LucaDorinAnton/6CCS3PRJ/Report/Appendices/SourceCode.tex

\chapter{Source Code}
This chapter contains the list of all source code created during this project.

\section{Originality Pledge}
``I verify that I am the sole author of the programs contained in this folder, except where explicitly stated to the contrary'' \\
Luca-Dorin Anton - 23 April 2020
\section{MicroCode generator}

\subsection{classes.py}
\lstinputlisting[language=Python]{../../microcode/classes.py}
\subsection{microcode.py}
\lstinputlisting[language=Python]{../../microcode/microcode.py}
\subsection{microinstructions.py}
\lstinputlisting[language=Python]{../../microcode/microinstructions.py}
\subsection{yamlparser.py}
\lstinputlisting[language=Python]{../../microcode/yamlparser.py}
\subsection{microinstructions.yaml}
\lstinputlisting{../../microcode/microinstructions.yaml}

\section{Assembler}
\subsection{assembler.scala}
\lstinputlisting[language=Scala]{../../build-tools/src/main/scala/assembler/assembler.scala}
\subsection{lexer.scala}
\lstinputlisting[language=Scala]{../../build-tools/src/main/scala/assembler/lexer.scala}
\subsection{LexerCore.scala}
\lstinputlisting[language=Scala]{../../build-tools/src/main/scala/assembler/LexerCore.scala}
\subsection{regexdef.scala}
\lstinputlisting[language=Scala]{../../build-tools/src/main/scala/assembler/regexdef.scala}
\subsection{regexdef.scala}
\lstinputlisting[language=Scala]{../../build-tools/src/main/scala/assembler/regexdef.scala}
\subsection{yamlparser.scala}
\lstinputlisting[language=Scala]{../../build-tools/src/main/scala/assembler/yaml_parser.scala}

\section{Compiler}
\subsection{ast.scala}
\lstinputlisting[language=Scala]{../../build-tools/src/main/scala/compiler/ast.scala}
\subsection{compiler.scala}
\lstinputlisting[language=Scala]{../../build-tools/src/main/scala/compiler/compiler.scala}
\subsection{lexer.scala}
\lstinputlisting[language=Scala]{../../build-tools/src/main/scala/compiler/lexer.scala}
\subsection{parser.scala}
\lstinputlisting[language=Scala]{../../build-tools/src/main/scala/compiler/parser.scala}

\section{Assembler and Compiler Script}
\subsection{script.scala}
\lstinputlisting[language=Scala]{../../build-tools/src/main/scala/script/script.scala}

\section{I/O Driver}
\subsection{io.ino}
\lstinputlisting[language=C++]{../../ardu-drivers/io/io.ino}
\subsection{io.py}
\lstinputlisting[language=Python]{../../ardu-drivers/io/io.py}

\section{Programming Driver}
\subsection{prog.ino}
\lstinputlisting[language=C++]{../../ardu-drivers/prog/prog.ino}
\subsection{prog.py}
\lstinputlisting[language=Python]{../../ardu-drivers/prog/prog.py}
