LucaDorinAnton/6CCS3PRJ/Report/Appendices/picture.tex

  \begin{figure}[h]
    \centering
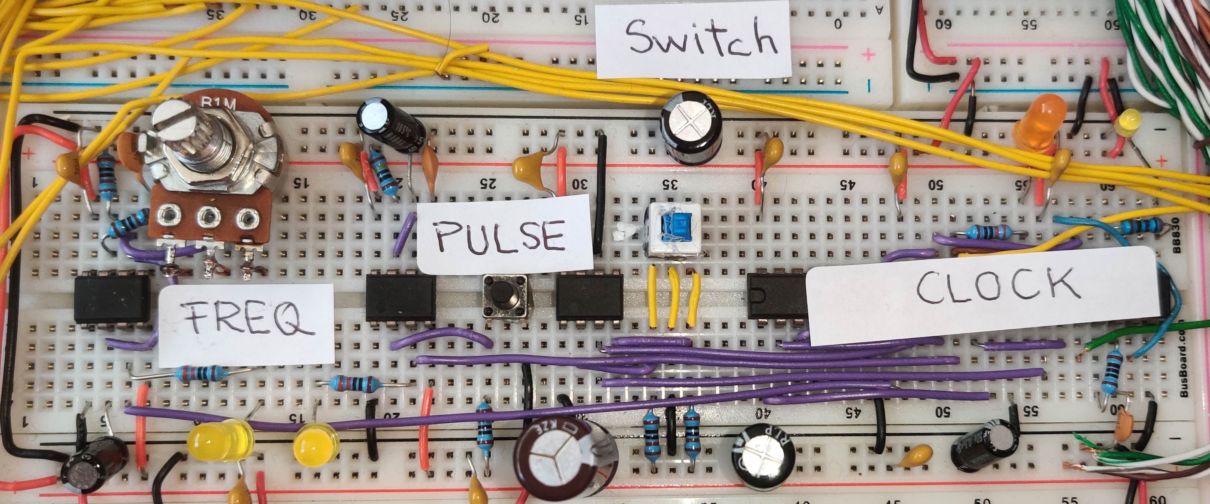
[picture p18: Report/Images/comp/clock.jpg]
    
    \caption{Clock implementation}
    \label{clock-i}
  \end{figure}

  \begin{figure}[h]
    \centering
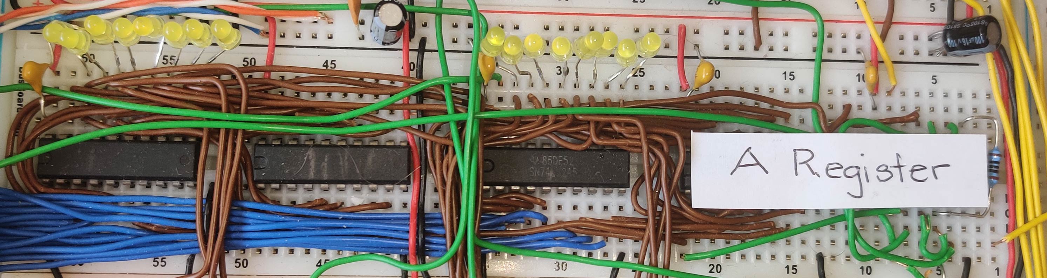
[picture p19: Report/Images/comp/a-reg.jpg]
    
    \caption{A register implementation}
    \label{a-reg-i}
  \end{figure}

  \begin{figure}[h]
    \centering
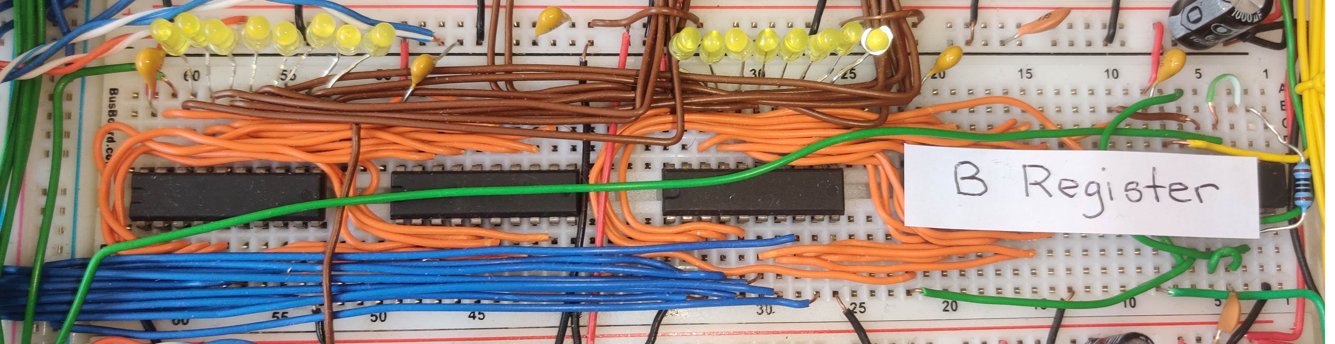
[picture p20: Report/Images/comp/b-reg.jpg]
    
    \caption{B register implementation}
    \label{b-reg-i}
  \end{figure}

  \begin{figure}[h]
    \centering
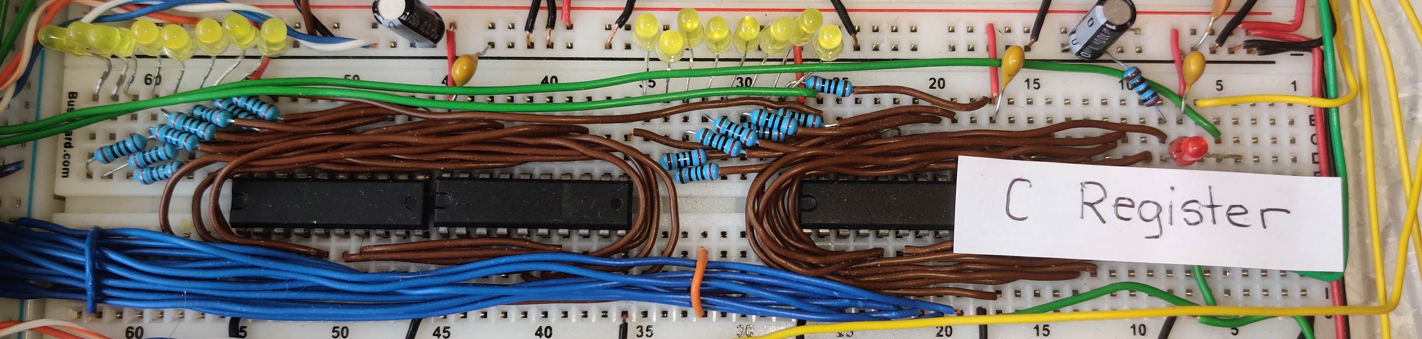
[picture p21: Report/Images/comp/c-reg.jpg]
    
    \caption{C register implementation}
    \label{c-reg-i}
  \end{figure}

  \begin{figure}[h]
    \centering
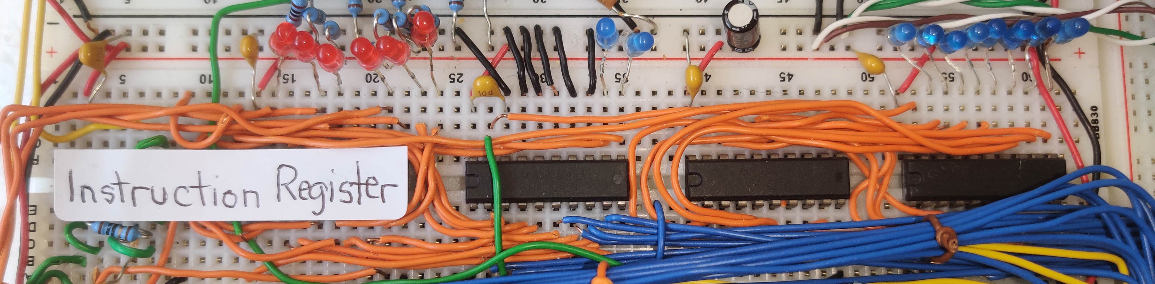
[picture p22: Report/Images/comp/ir.jpg]
    
    \caption{Instruction register implementation}
    \label{ir-i}
  \end{figure}

  \begin{figure}[h]
    \centering
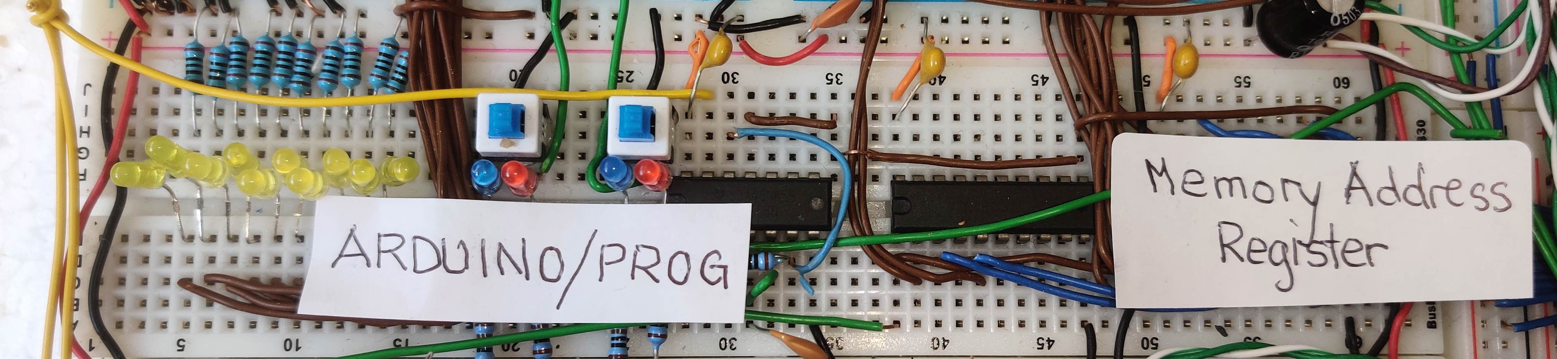
[picture p23: Report/Images/comp/mar.jpg]
    
    \caption{Memory address register implementation}
    \label{mar-i}
  \end{figure}

  \begin{figure}[h]
    \centering
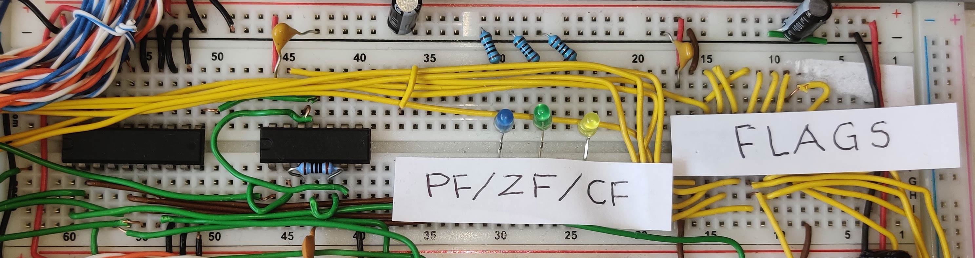
[picture p24: Report/Images/comp/flags.jpg]
    
    \caption{Flags register implementation}
    \label{flags-i}
  \end{figure}

  \begin{figure}[h]
    \centering
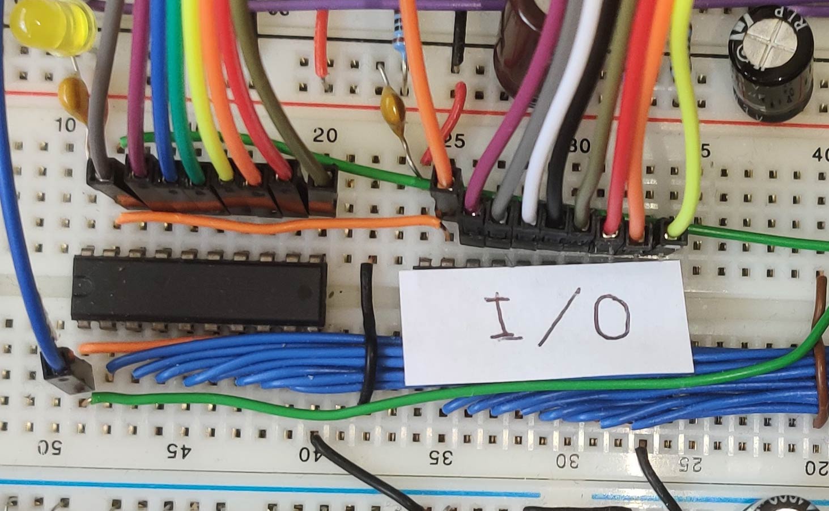
[picture p25: Report/Images/comp/io.jpg]
    
    \caption{Input/Output implementation}
    \label{io-i}
  \end{figure}

  \begin{figure}[h]
    \centering
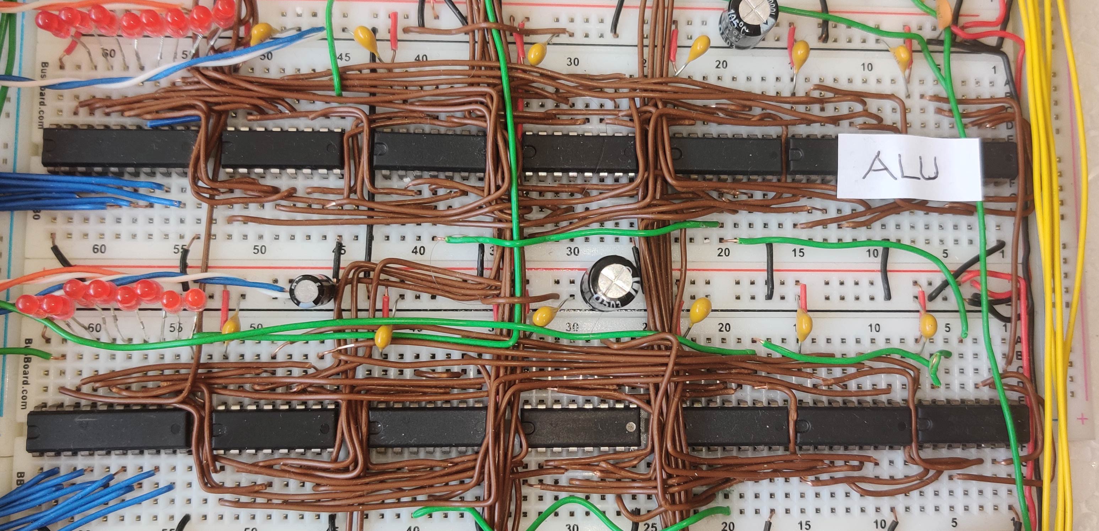
[picture p26: Report/Images/comp/alu.jpg]
    
    \caption{Arithmetic-Logic Unit implementation}
    \label{alu-i}
  \end{figure}

  \begin{figure}[h]
    \centering
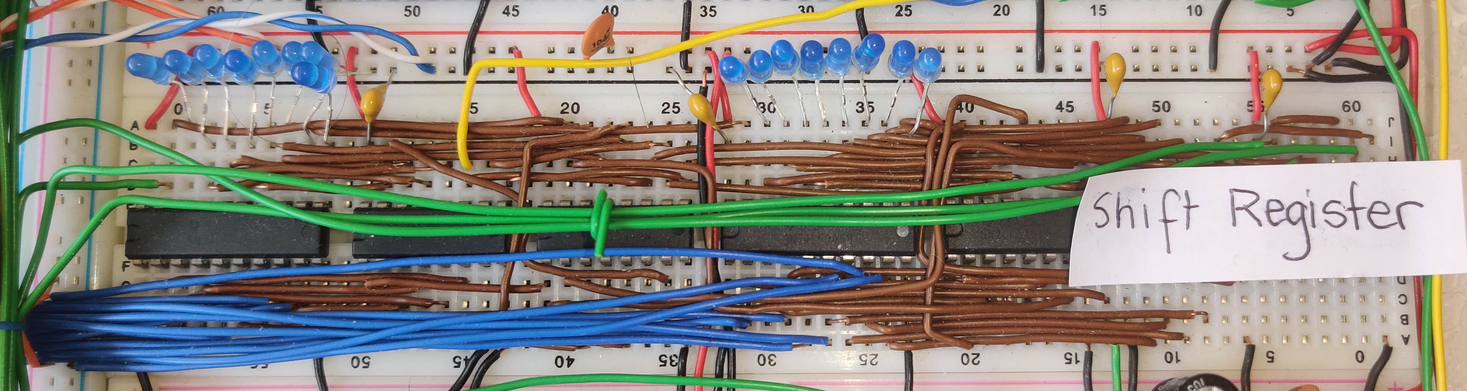
[picture p27: Report/Images/comp/shift-reg.jpg]
    
    \caption{Shift Register implementation}
    \label{shift-reg-i}
  \end{figure}

  \begin{figure}[h]
    \centering
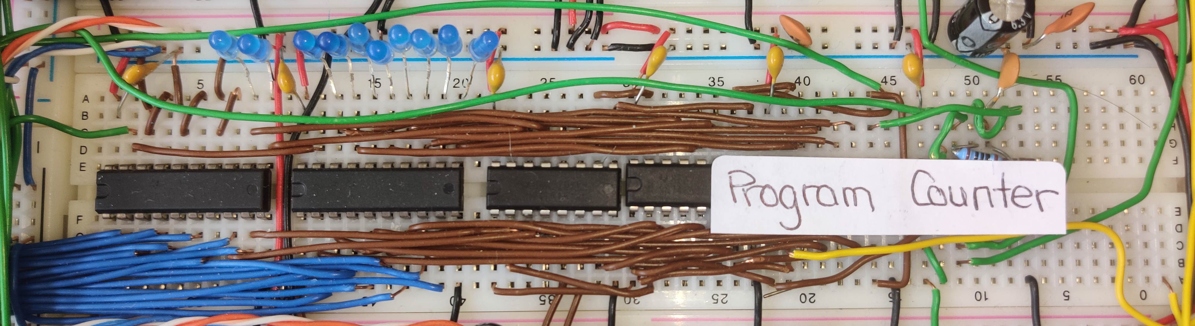
[picture p28: Report/Images/comp/pc.jpg]
    
    \caption{Program Counter implementation}
    \label{pc-i}
  \end{figure}

  \begin{figure}[h]
    \centering
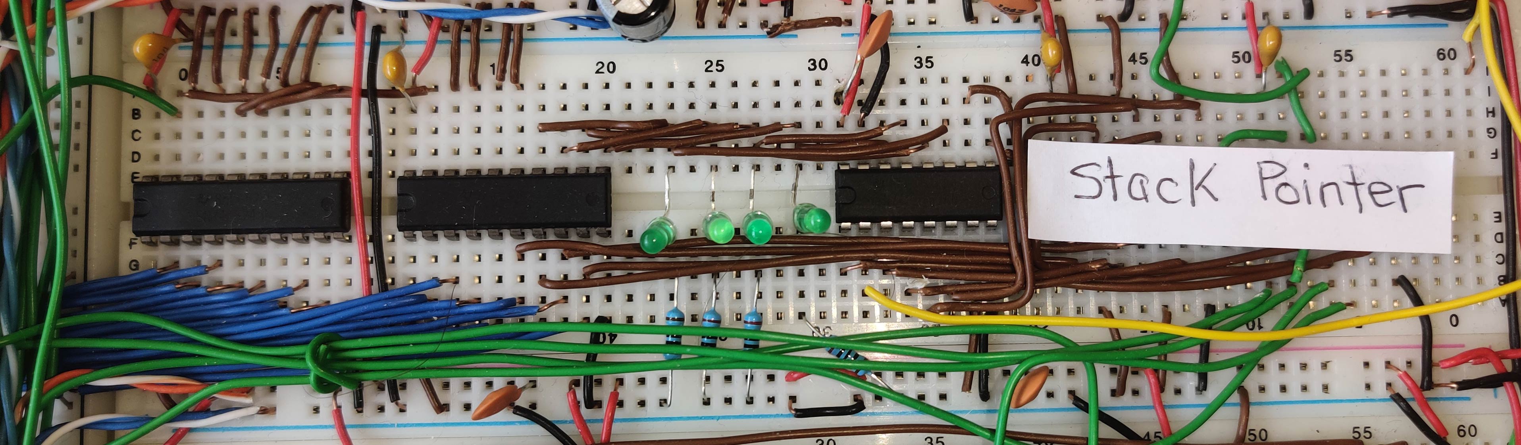
[picture p29: Report/Images/comp/sp.jpg]
    
    \caption{Stack Pointer implementation}
    \label{sp-i}
  \end{figure}

  \begin{figure}[h]
    \centering
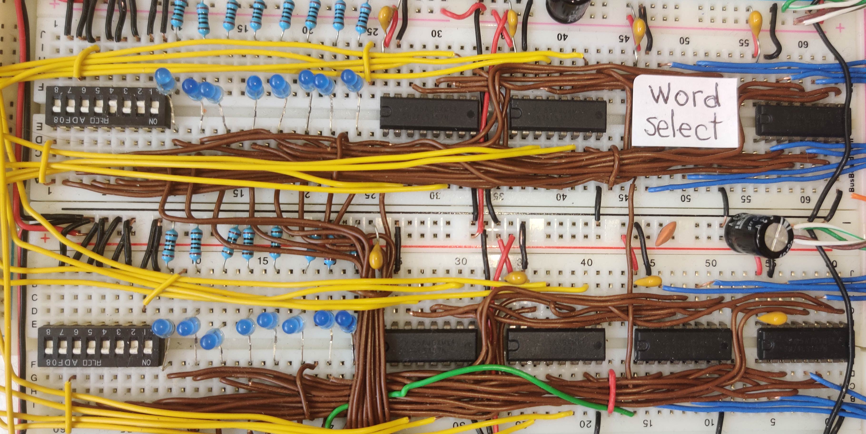
[picture p30: Report/Images/comp/word-select.jpg]
    
    \caption{Word selector implementation}
    \label{word-select-i}
  \end{figure}

  \begin{figure}[h]
    \centering
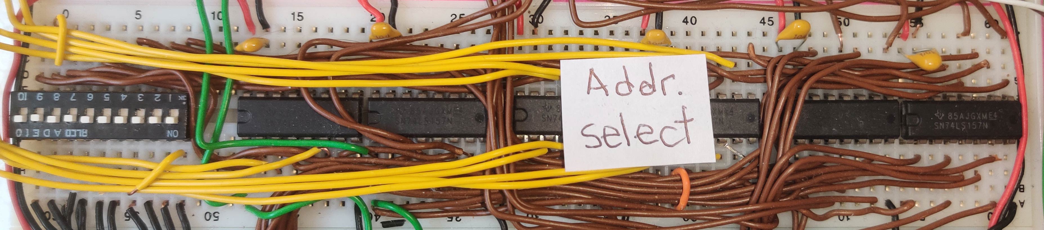
[picture p31: Report/Images/comp/addr-select.jpg]
    
    \caption{Address selector implementation}
    \label{addr-select-i}
  \end{figure}

  \begin{figure}[h]
    \centering
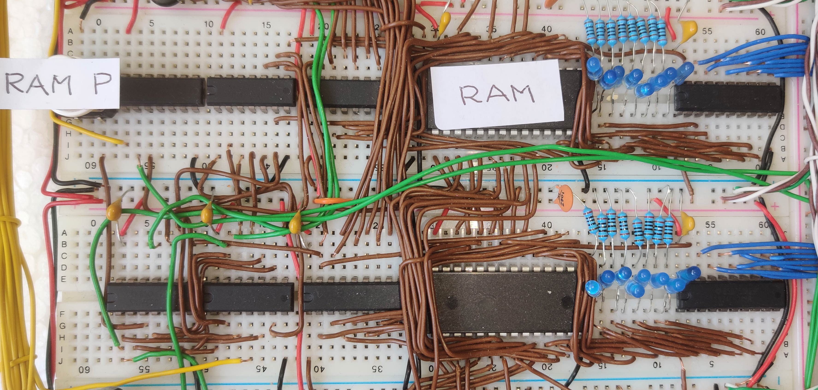
[picture p32: Report/Images/comp/ram.jpg]
    
    \caption{Random Access Memory implementation}
    \label{ram-i}
  \end{figure}

  \begin{figure}[h]
    \centering
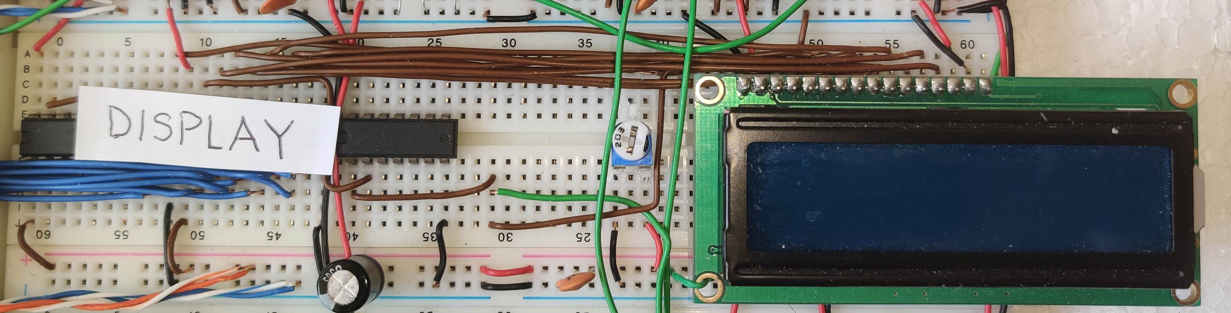
[picture p33: Report/Images/comp/display.jpg]
    
    \caption{Display implementation}
    \label{display-i}
  \end{figure}

  \begin{figure}[h]
    \centering
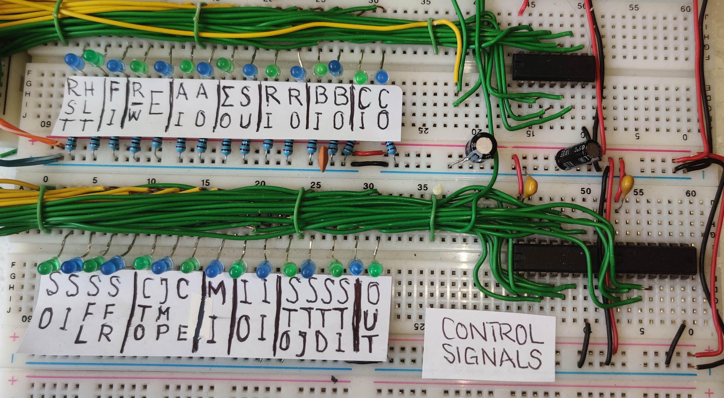
[picture p34: Report/Images/comp/control-sigs.jpg]
    
    \caption{Implementation of the contol signals module}
    \label{control-sigs-i}
  \end{figure}

  \begin{figure}[h]
    \centering
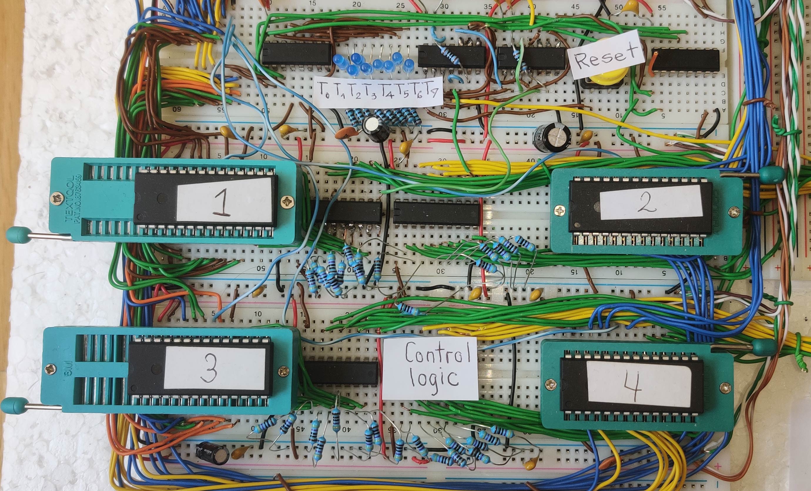
[picture p35: Report/Images/comp/control-logic.jpg]
    
    \caption{Control Logic implementation}
    \label{control-logic-i}
  \end{figure}

  \begin{figure}[h]
    \centering
    
    \caption{High level overview (with bus and LEDs visible)}
    \label{high-level-i}
  \end{figure}

\cleardoublepage
\cleardoublepage
