LucaDorinAnton/6CCS3PRJ/photoshop/BPS-BB830_Top.jpg

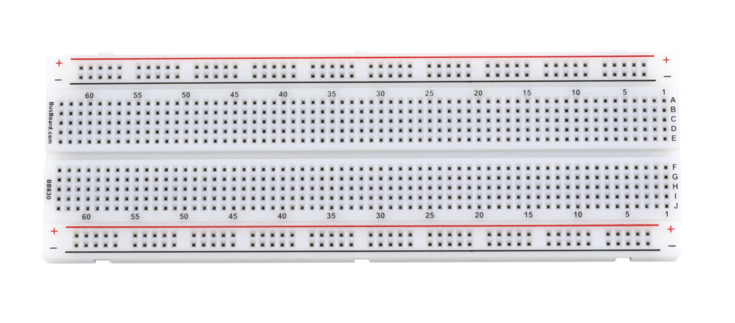
photoshop/BPS-BB830_Top.jpg
