LucaDorinAnton/6CCS3PRJ/Report/Images/close_up_low_level.jpg

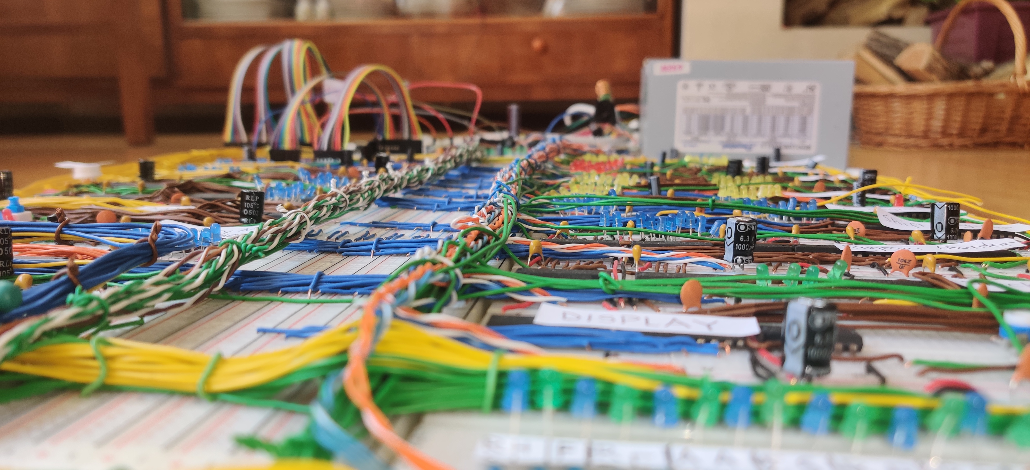
Report/Images/close_up_low_level.jpg
