LucaDorinAnton/6CCS3PRJ/Report/Images/comp/arduinos.jpg

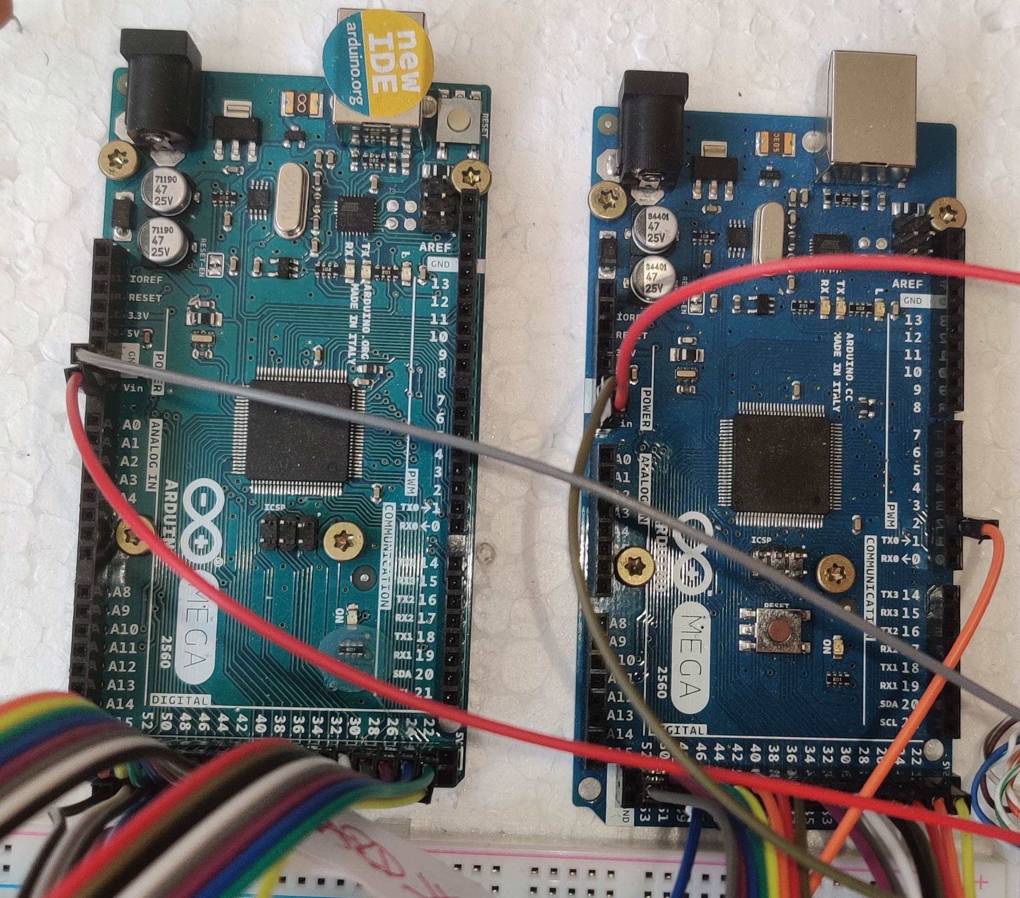
Report/Images/comp/arduinos.jpg
