LucaDorinAnton/6CCS3PRJ/Report/Images/comp/leds_and_ground.jpg

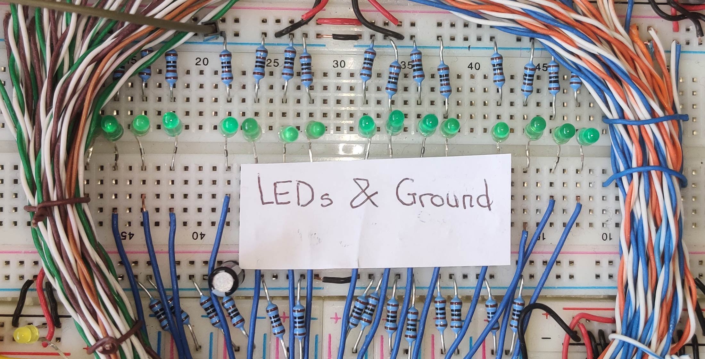
Report/Images/comp/leds_and_ground.jpg
