LucaDorinAnton/6CCS3PRJ/Report/Images/trans.PNG

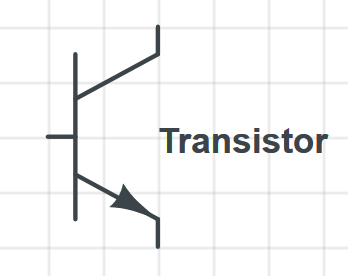
Report/Images/trans.PNG
