LucaDorinAnton/6CCS3PRJ/Other/Shopping List.xlsx

No | Code | Name | Needed | Cnty. | Unit Price | Total Price | Link
1 | MCBB830 | Breadboard | 15 | 17 | 3.67 | 62.39 | https://uk.farnell.com/multicomp/mcbb830/bread-board-abs-solderless-56/dp/2527467
2 | MCBB100 | Strips | 5 | 8 | 1.75 | 14 | https://uk.farnell.com/multicomp/mcbb100/bread-board-abs-165-3mm-x-20-5mm/dp/2764642?MER=sy-me-pd-mi-alte
3 | MCFYU6104Z6 (https://uk.farnell.com/multicomp/mcfyu6104z6/cap-0-1-f-50v-y5v/dp/9411887) | Caps 0.1 uF | 15 | 20 | 0.191 | 3.82 | https://uk.farnell.com/c/passive-components/capacitors/ceramic-capacitors/ceramic-disc-plate-capacitors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
4 | Se furaaaaa | R 220 Ohm | 150 | 200 |  | 0
5 | 1-1825002-3 (https://uk.farnell.com/te-connectivity/1-1825002-3/dip-switch-8pos-spst-slide/dp/2452332) | Dip Switches 8x | 2 | 2 | 0.8 | 1.6 | https://uk.farnell.com/te-connectivity/1-1825002-3/dip-switch-8pos-spst-slide/dp/2452332
6 | 1825057-9 (https://uk.farnell.com/te-connectivity/1825057-9/dip-switch-10pos-spst-slide/dp/2468732) | Dip Switches 10x | 1 | 1 | 1.15 | 1.15 | https://uk.farnell.com/te-connectivity/1825057-9/dip-switch-10pos-spst-slide/dp/2468732
7 | 74ls04 | hex inverter | 5 | 10 |  | 0 | https://uk.farnell.com/texas-instruments/sn74ls04n/ic-hex-inverter-74lso4-14dip/dp/3120520?st=74ls04
8 | 74ls08 | 4x 2 input and gates | 14 | 20 | 0.428 | 8.56 | https://uk.farnell.com/texas-instruments/sn74ls04n/ic-hex-inverter-74lso4-14dip/dp/1106072?st=74ls04
9 | 74ls32 | 4x 2 input or gates | 4 | 10 | 0.415 | 4.15 | https://uk.farnell.com/texas-instruments/cd74hc32e/logic-2-in-or-gate-quad-hs-14dip/dp/3120203
10 | 74ls273 | 8 bit register | 11 | 15 | 0.518 | 7.77 | https://uk.farnell.com/texas-instruments/sn74ls273n/ic-flipflop-8-circuits-17ns-20dip/dp/1470820?st=74ls273
11 | 74ls245 | tri state buffers | 24 | 30 | 0.543 | 16.29 | https://uk.farnell.com/texas-instruments/sn74ls245n/ic-74ls-74ls245-dip20-5-25v/dp/1106085?st=74ls245
12 | 74ls86 | 4x 2 input xor | 4 | 8 | 0.358 | 2.864 | https://uk.farnell.com/texas-instruments/sn74ls86an/logic-quad-2-in-ex-or-gate-14dip/dp/1740036?st=74ls86
13 | 74ls283 | 4 bit adder | 4 | 8 | 1.2 | 9.6 | https://uk.farnell.com/texas-instruments/sn74ls283n/logic-4bit-binary-full-adder-16dip/dp/3121044?st=74ls283
14 | 74ls02 | 4x 2 input nor | 3 | 6 | 0.458 | 2.748 | https://uk.farnell.com/texas-instruments/sn74ls02n/logic-quad-2-input-nor-gate-14dip/dp/3120517?st=74ls02
15 | 74ls194 | 4 bit shift register | 4 | 6 | 1.16 | 6.96 | https://uk.farnell.com/texas-instruments/sn74ls194an/logic-bi-dir-univ-shift-reg-16dip/dp/3120870?st=74ls194
16 | 74ls157 | 2 to 1 multiplexer | 15 | 20 | 0.57 | 11.4 | https://uk.farnell.com/texas-instruments/sn74ls157n/ic-74ls-74ls157-dip16-5-25v/dp/3121113?st=74ls157
17 | 74ls161 | 4 bit counter | 4 | 6 | 0.529 | 3.174 | https://uk.farnell.com/texas-instruments/sn74ls161an/ic-counter-multiplier-divider/dp/1470779?st=74ls161
18 | 74ls00 | 4x 2 input nand | 3 | 6 | 0.387 | 2.322 | https://uk.farnell.com/texas-instruments/sn74ls00n/logic-quad-2-in-nand-gate-14dip/dp/1740021?st=74ls00
19 | MC21605C6W | Display | 1 | 1 | 7.35 | 7.35 | https://uk.farnell.com/midas/mc21605c6w-spr-v2/display-alphanumeric-16x2-nobacklight/dp/2675590?st=MC21605C6W
20 | 74ls169 | up/down counter | 1 | 2 | 1.05 | 2.1 | https://uk.farnell.com/texas-instruments/sn74ls169bn/logic-sync-4bit-up-dn-cntr-16dip/dp/1739788?ost=74ls169
21 | 74ls138 | 3 to 8 line decoder | 1 | 2 | 0.494 | 0.988 | https://uk.farnell.com/texas-instruments/sn74ls138n/logic-3-8-line-decoder-demux-16dip/dp/1739824?st=74ls138
22 | 28C64 | EEPROM | 4 | 6 | 3.8 | 22.8 | https://uk.farnell.com/atmel/at28c64b-15pu/parallel-eeprom-64kbit-dip-28/dp/2748830
23 | LY62256PL-55LLI | RAM | 2 | 3 | 4.53 | 13.59 | https://uk.farnell.com/lyontek/ly62256pl-55lli/sram-256k-32kx8-2-7-5-5v-28pdip/dp/2253656?ost=LY62256PL-55LLI
24 | tl866II | Eeprom programmer | 1 | 1 | 38.49 | 38.49 | https://www.amazon.co.uk/WINGONEER%C2%AE-TL866II-Performance-EEPROM-Programmer/dp/B07B985LBS
25 |  |  |  |  |  | 0
26 |  |  |  |  |  | 0
27 |  |  |  |  |  | 0
28 |  |  |  |  |  | 0
29
 |  |  |  |  | TOTAL: | 244.116
