LucaDorinAnton/6CCS3PRJ/microcode/instruction_list.txt

NOP
LDA
LAI
LDB
LBI
LDC
LCI
LDS
LSI
ADD
SUB
SFL
SFR
JMP
JPI
BRZ
BRP
BRC
MAB
MAC
MAS
MBA
MBC
MBS
MCA
MCB
MCS
MSA
MSB
MSC
STA
STB
STC
STS
JSR
RET
IRA
IRB
IRC
IRS
IRR
IWA
IWB
IWC
IWS
IWR
DWA
DWB
DWC
DWS
DWR
LAP
LBP
LCP
LSP
RST
HLT
