LucaDorinAnton/6CCS3PRJ/KiCad/breadboard_comp_schematic.pdf

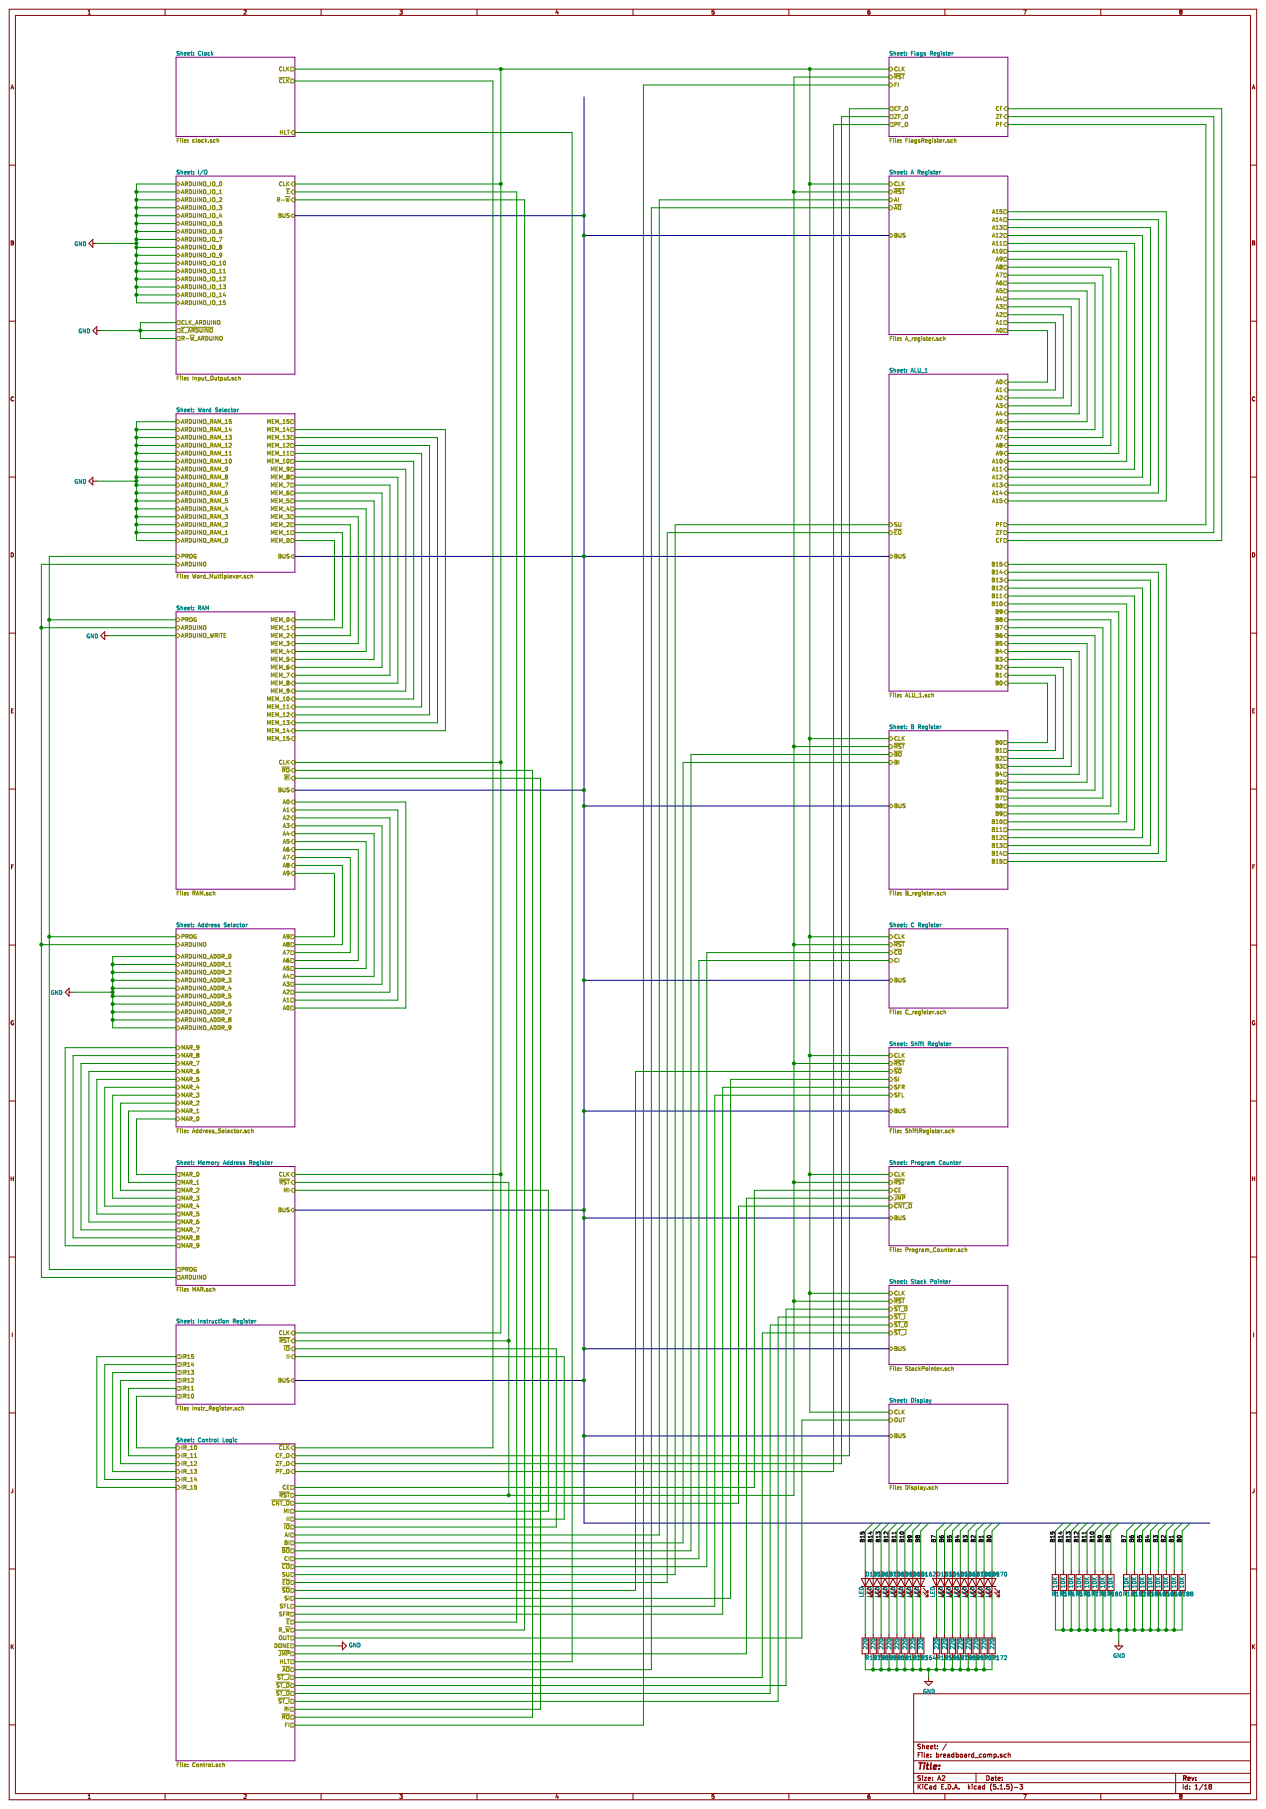
[picture p73: page 1]

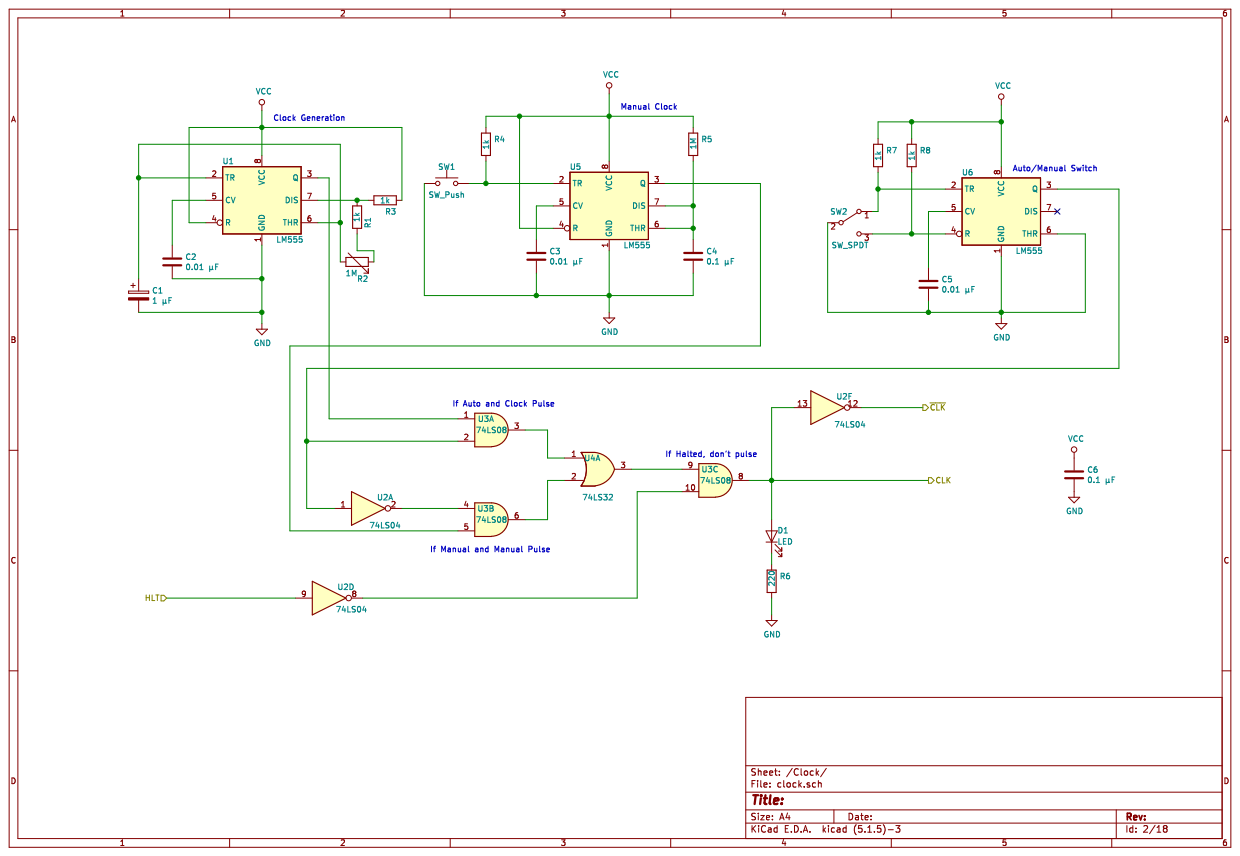
[picture p74: page 2]

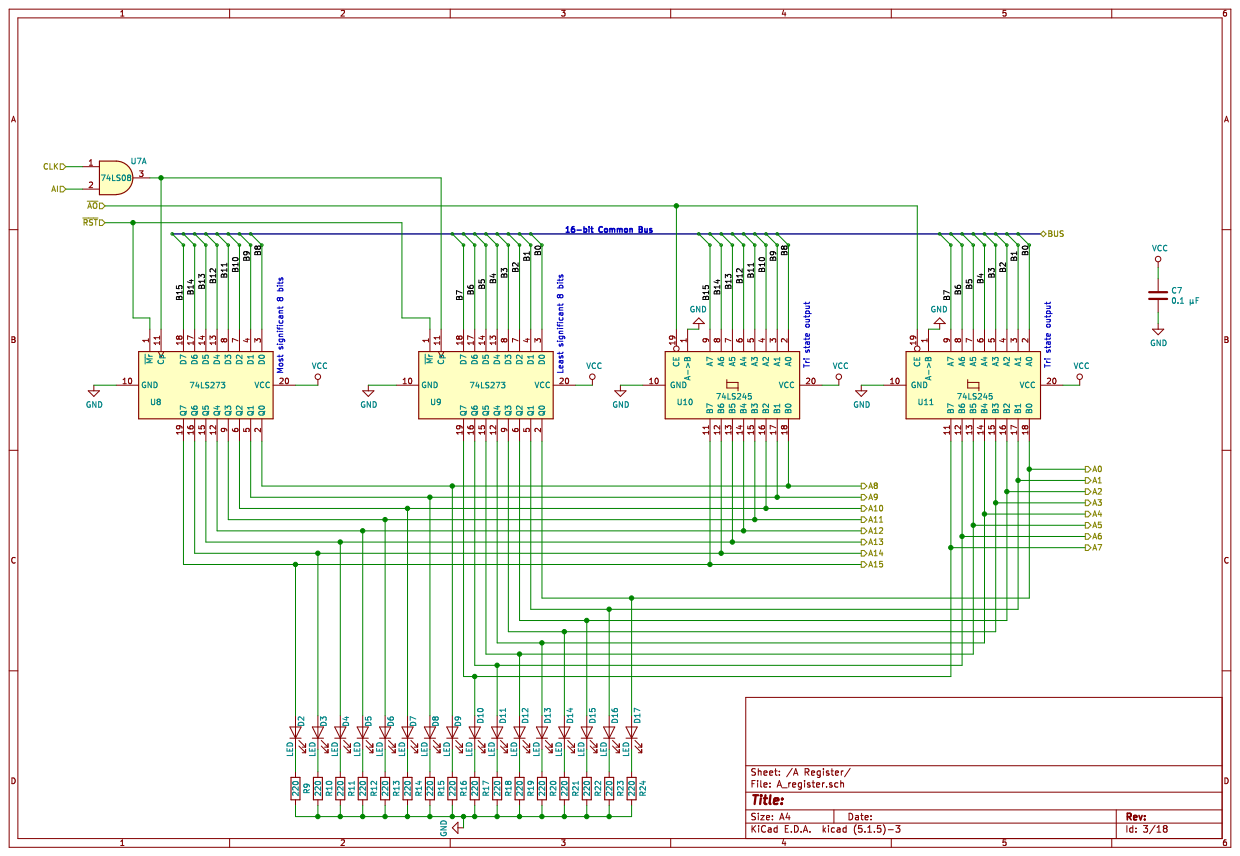
[picture p75: page 3]

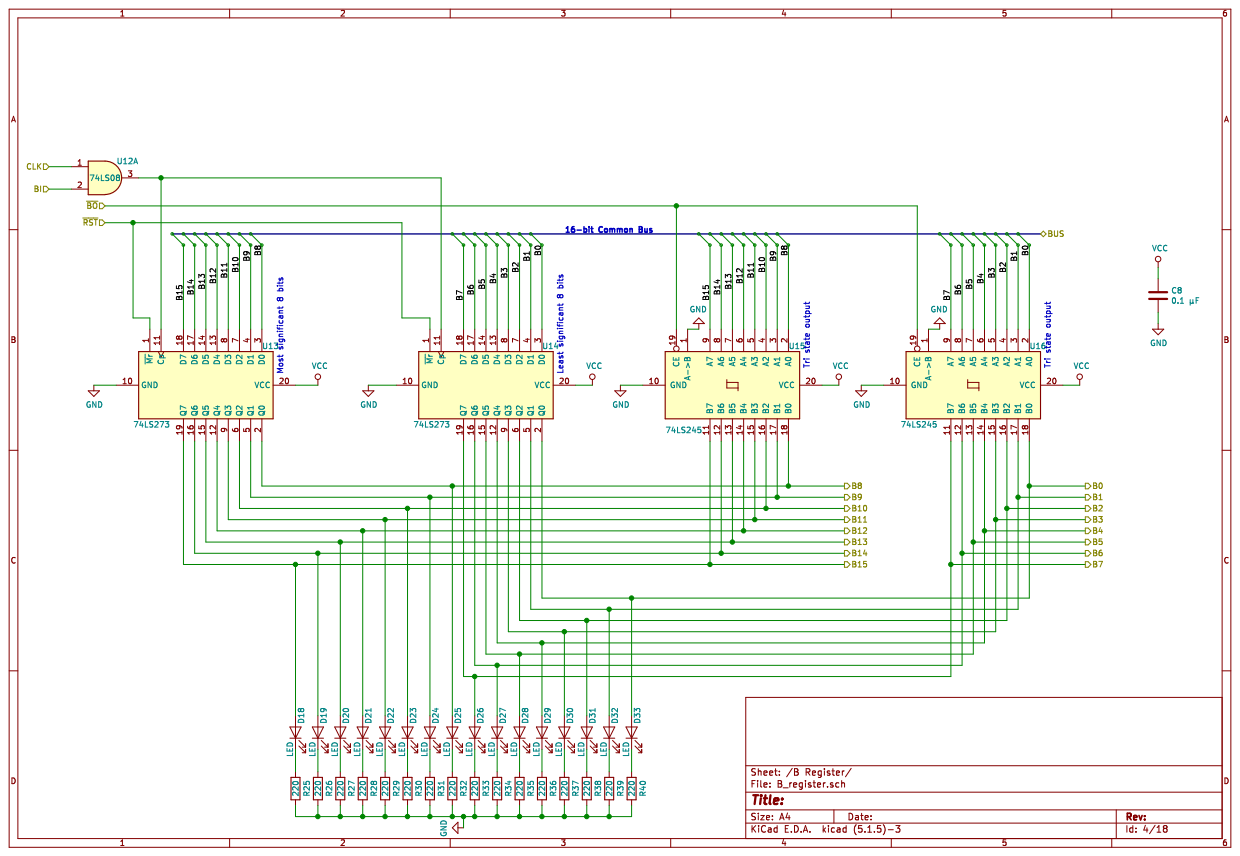
[picture p76: page 4]

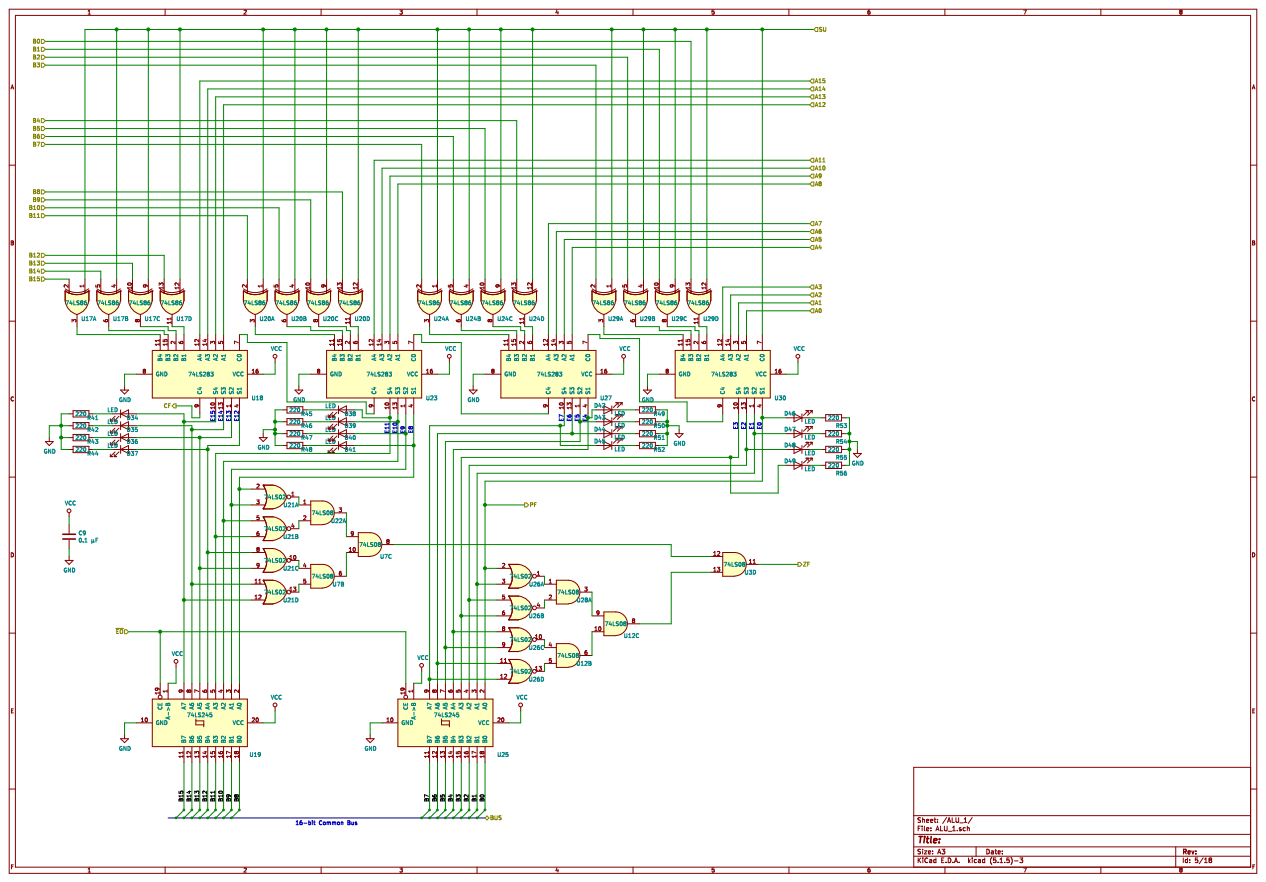
[picture p77: page 5]

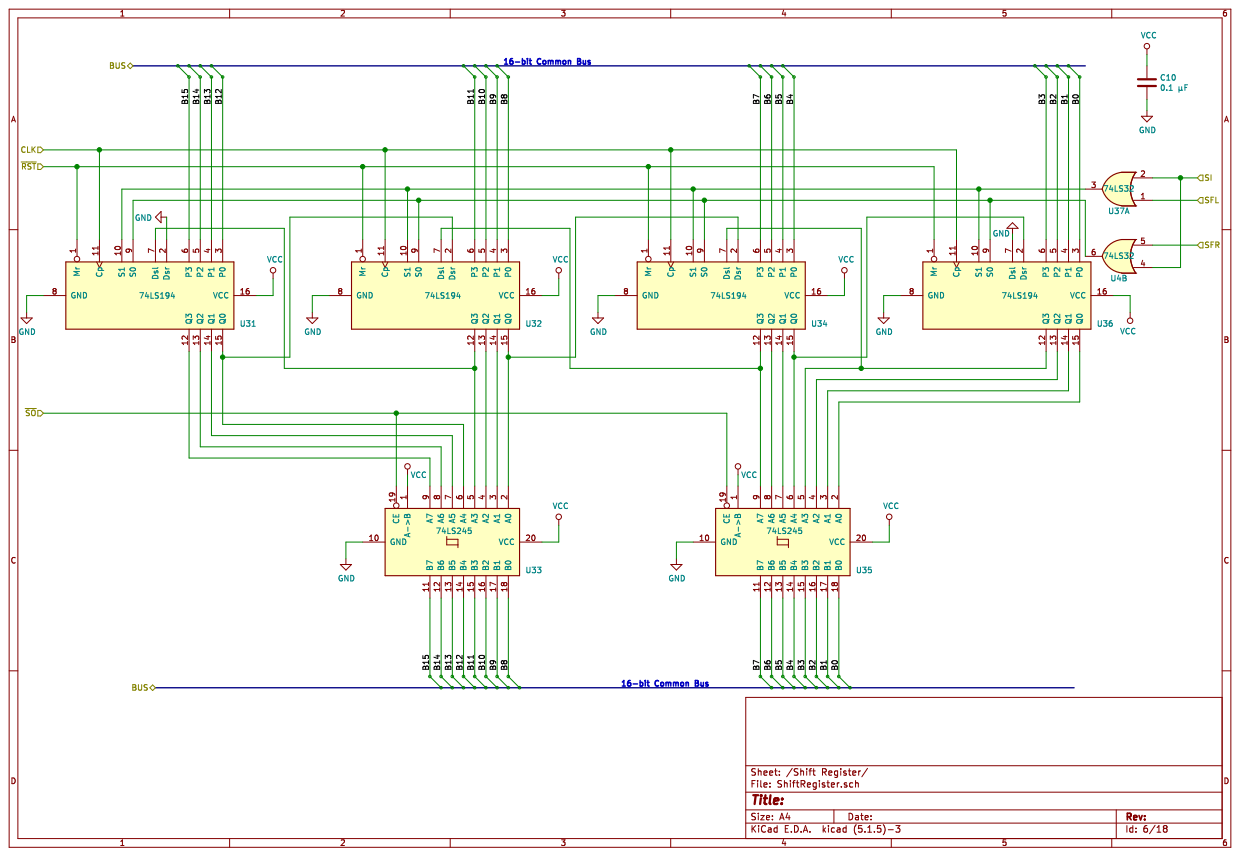
[picture p78: page 6]

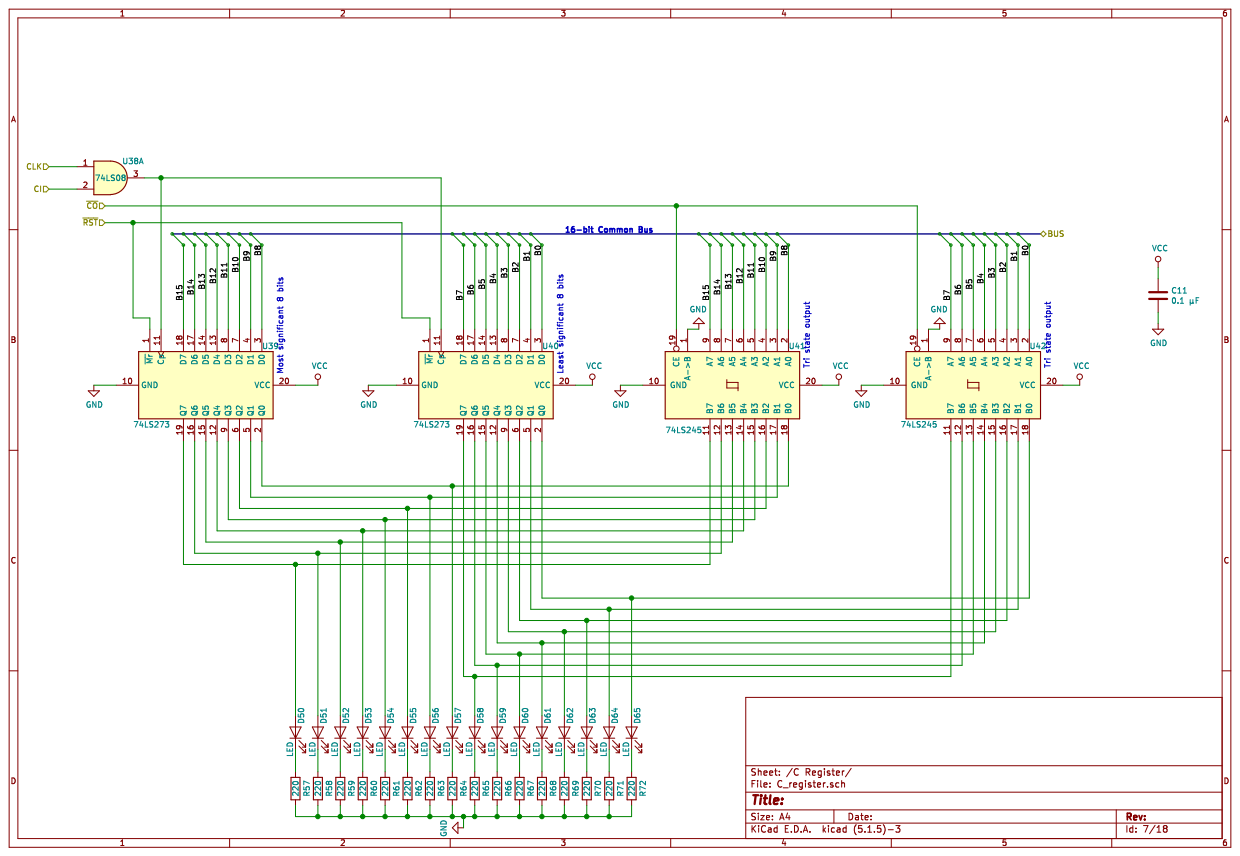
[picture p79: page 7]

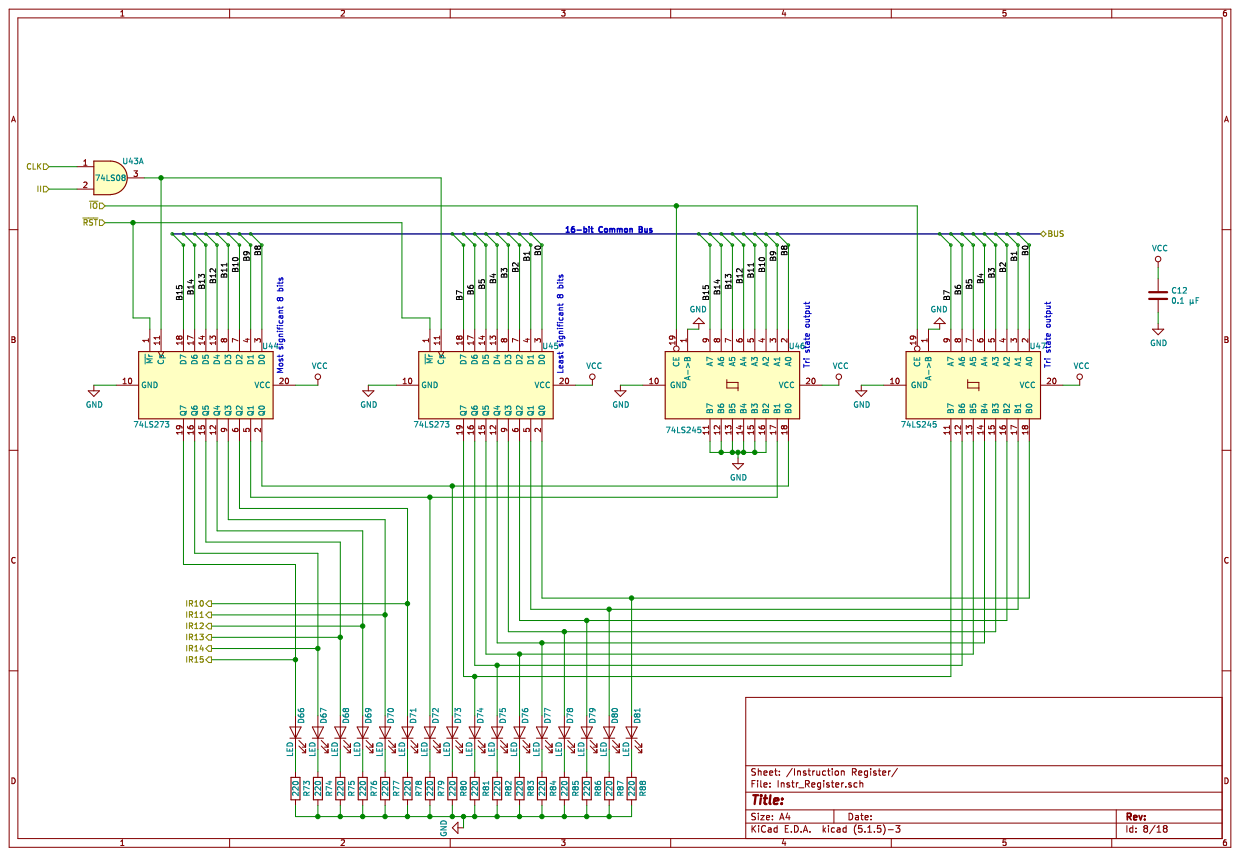
[picture p80: page 8]

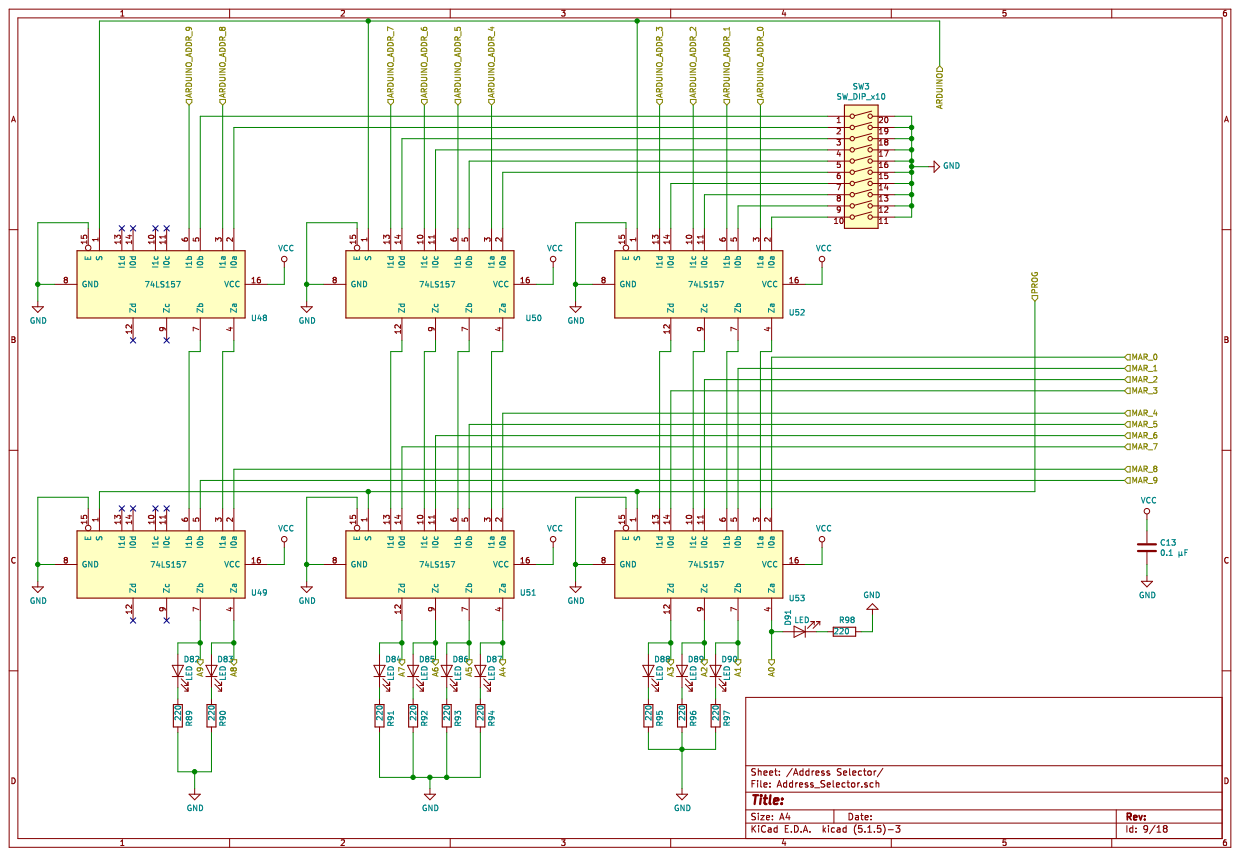
[picture p81: page 9]

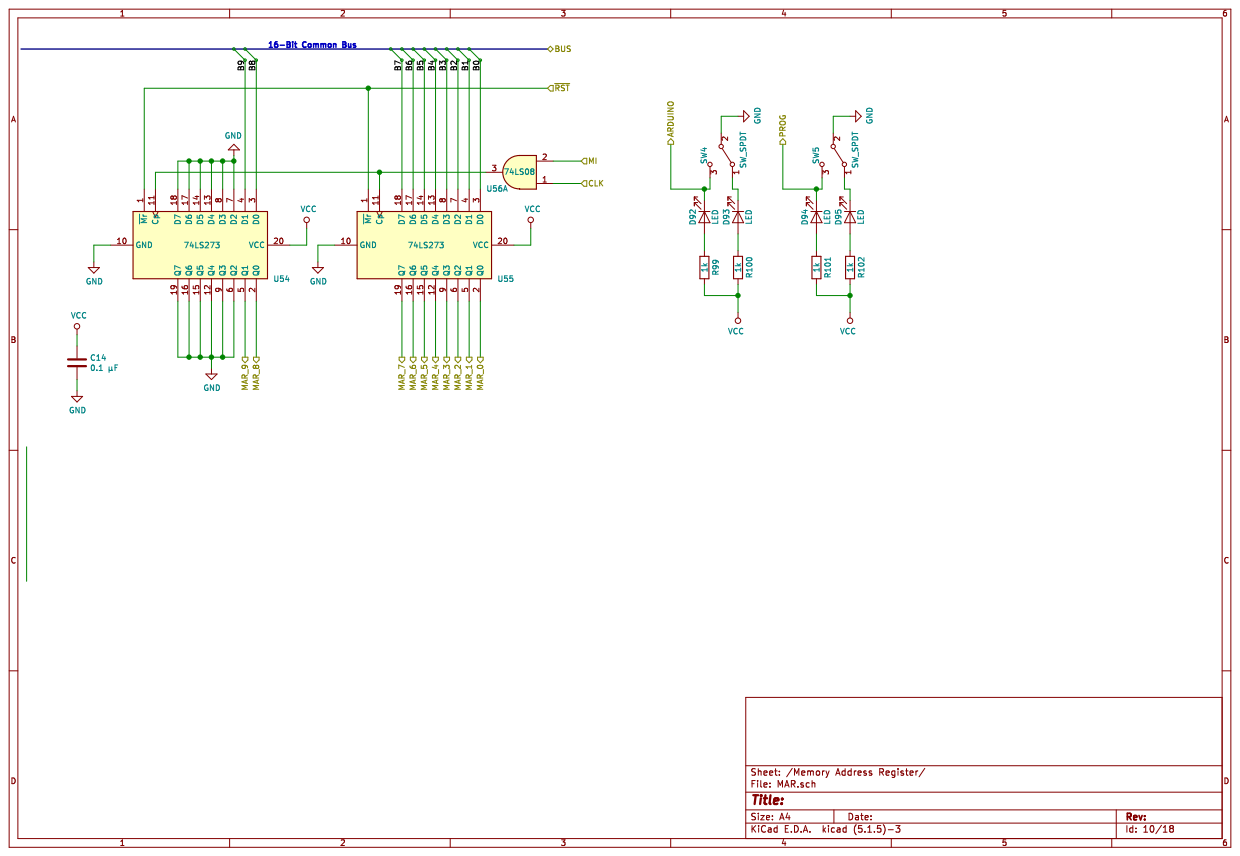
[picture p82: page 10]

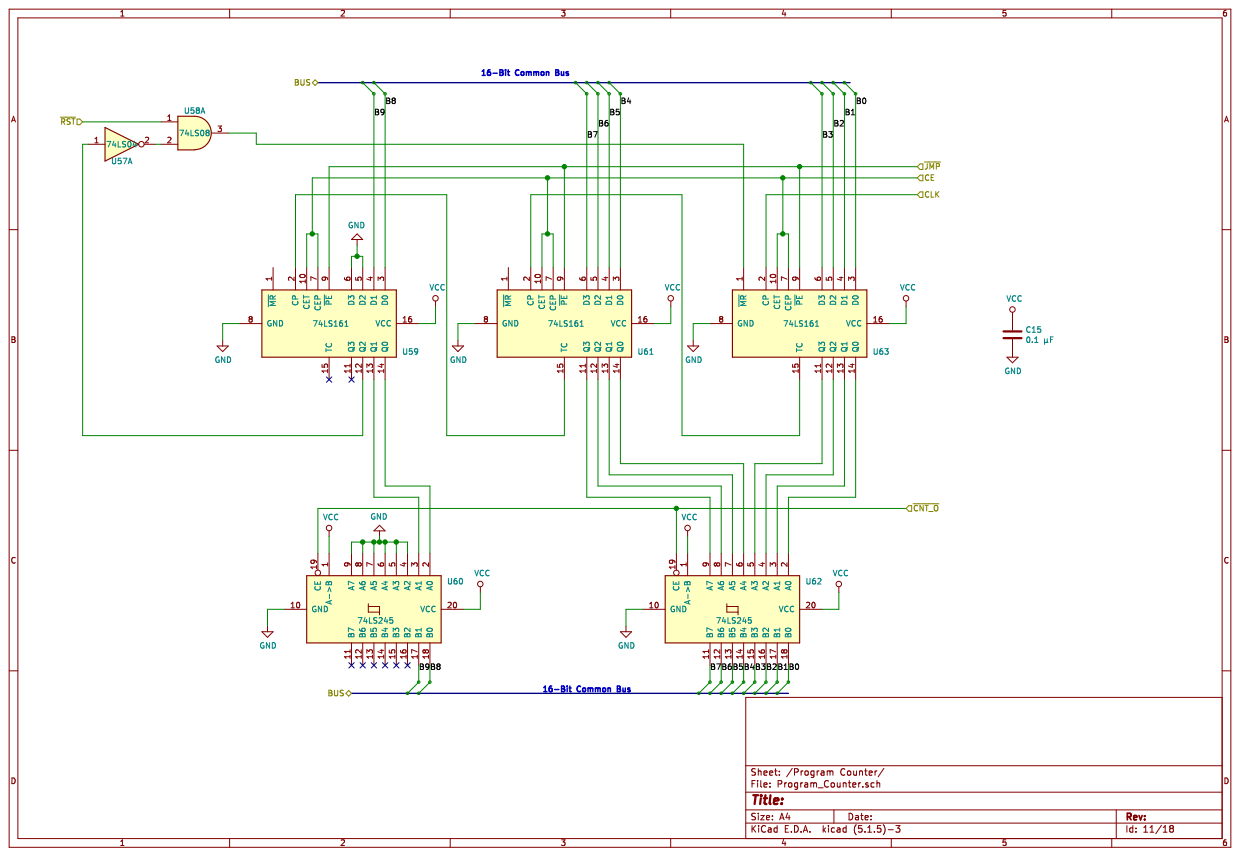
[picture p83: page 11]

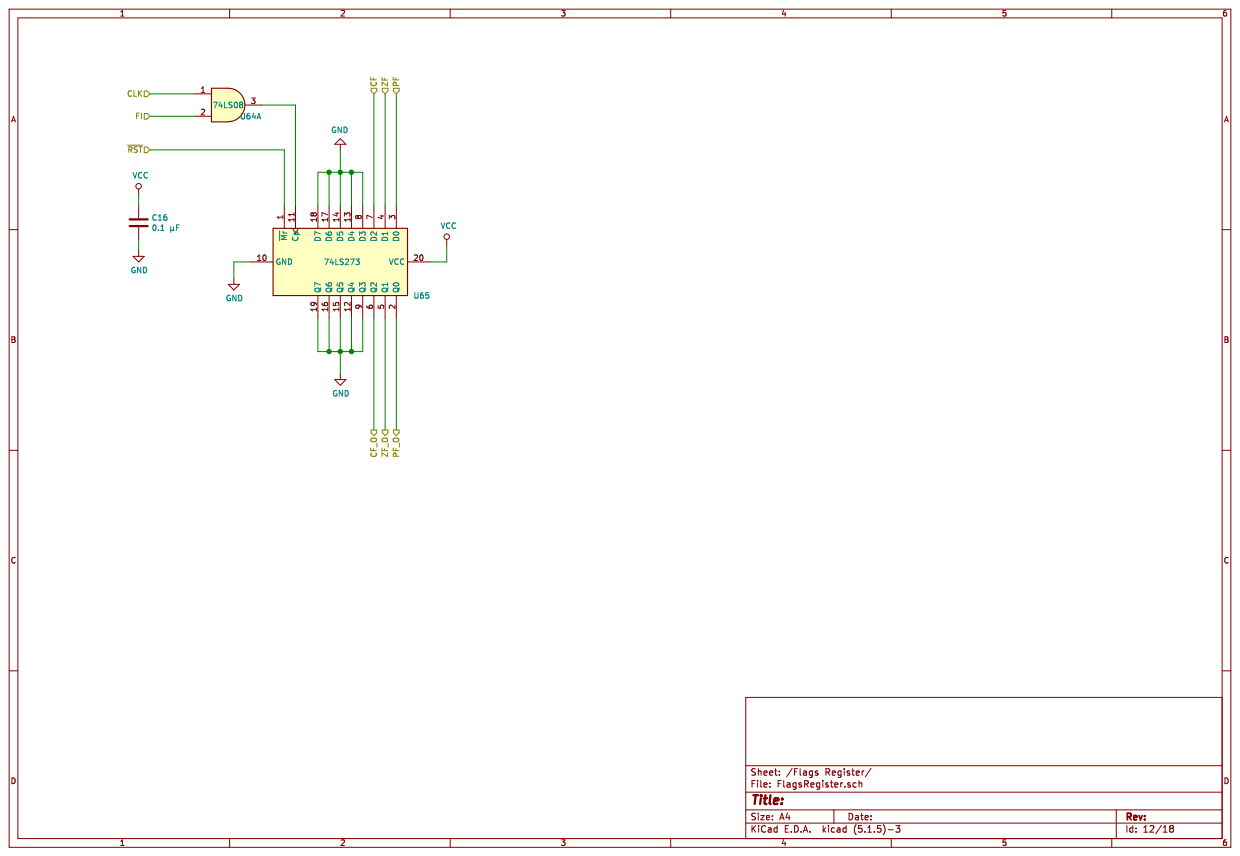
[picture p84: page 12]

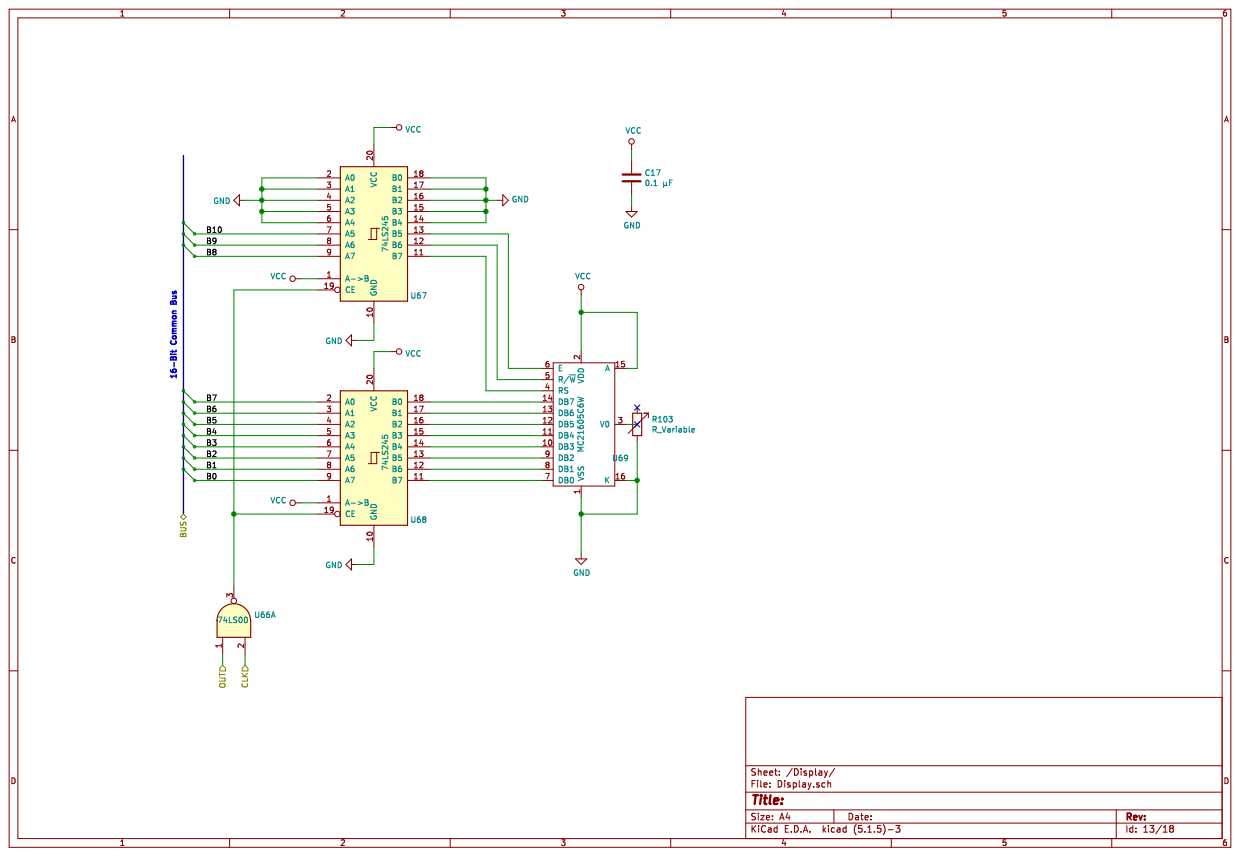
[picture p85: page 13]

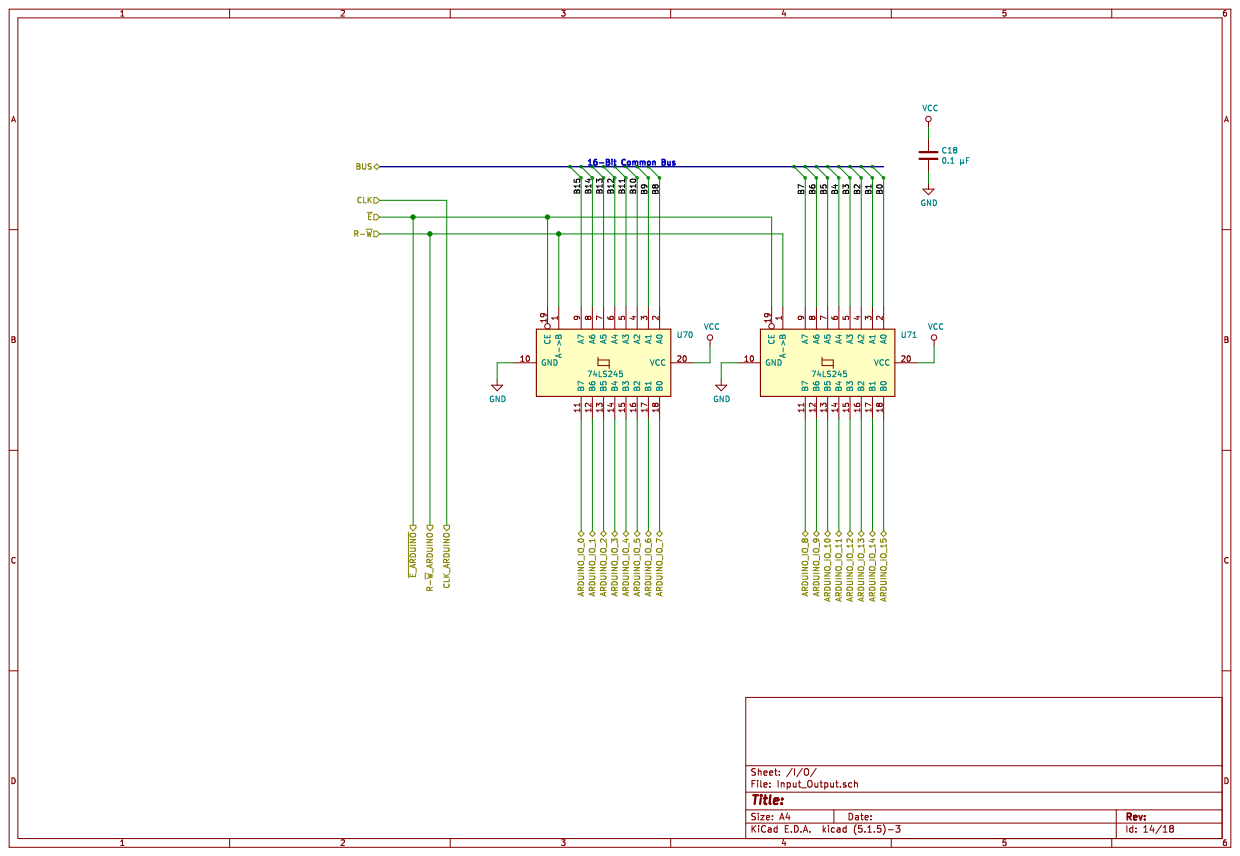
[picture p86: page 14]

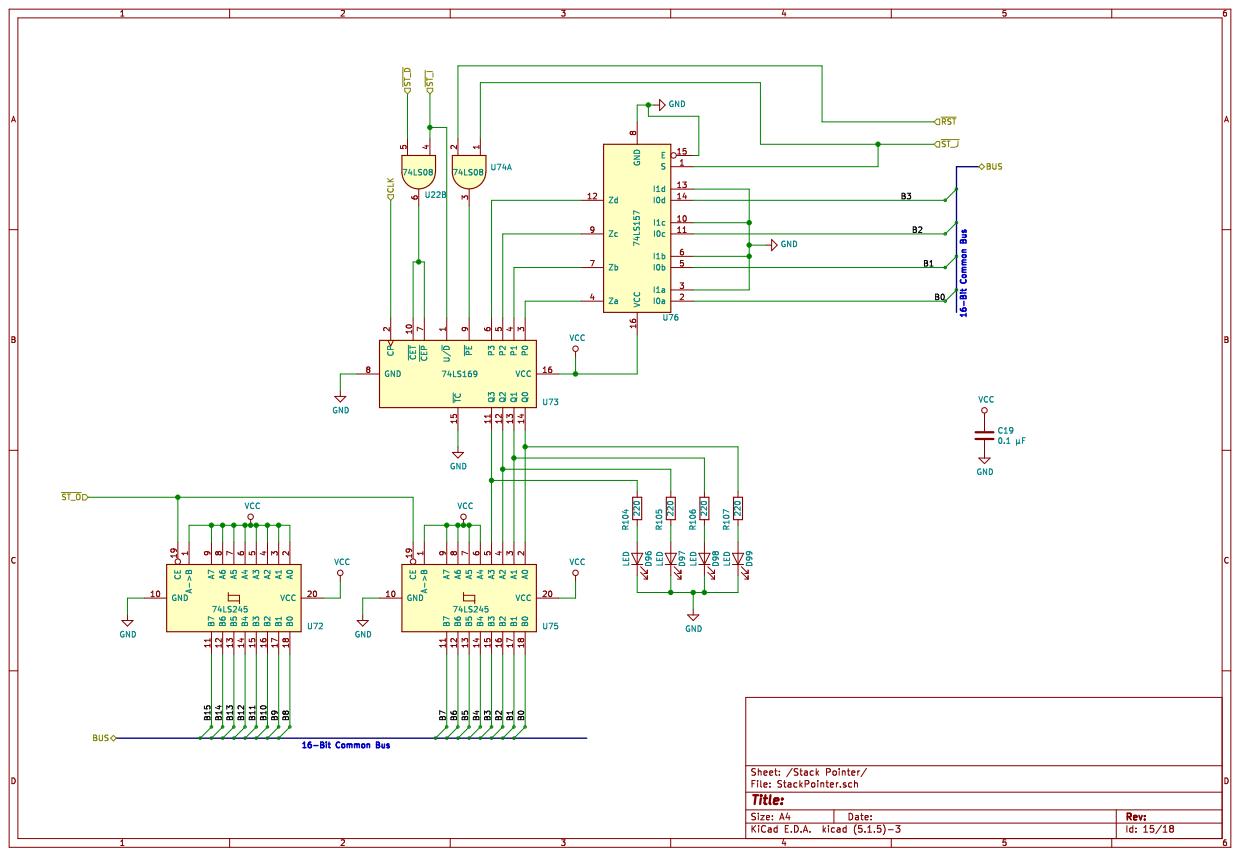
[picture p87: page 15]

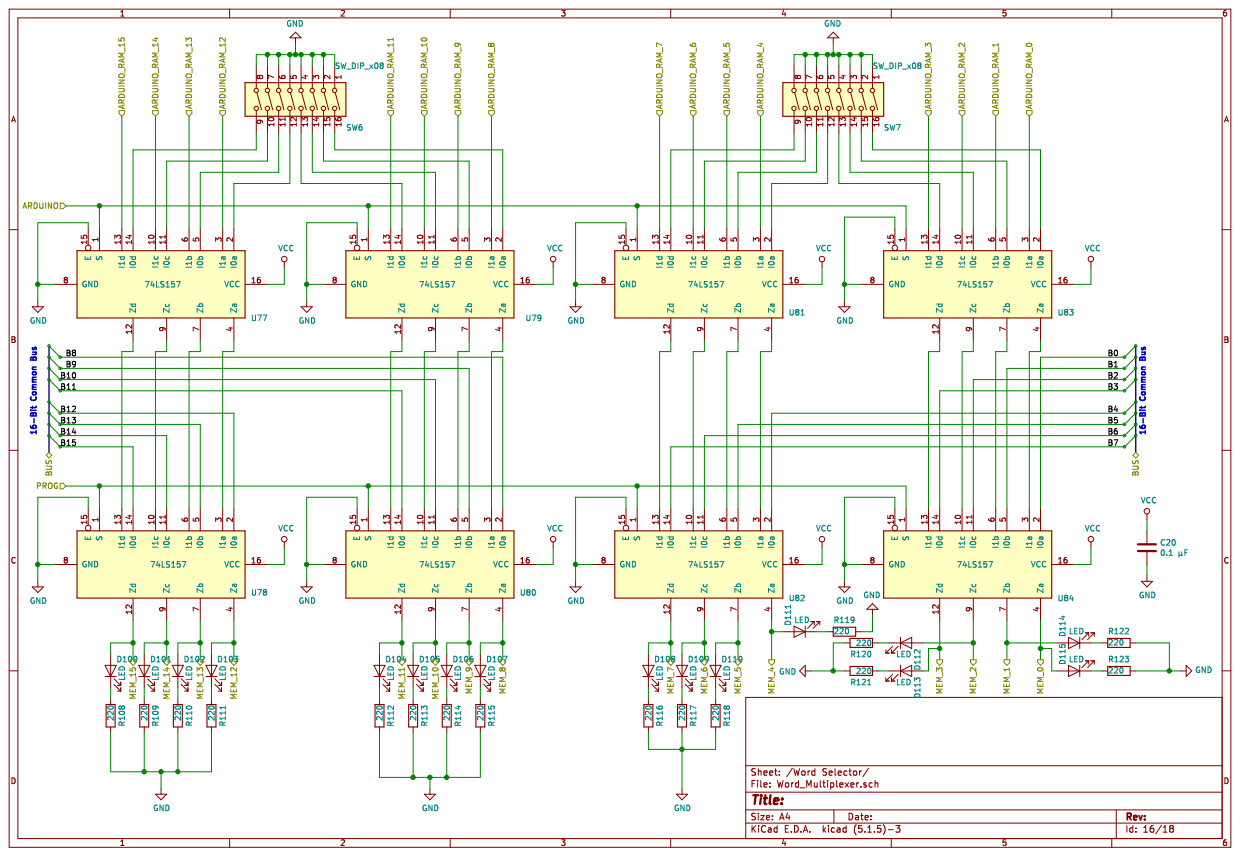
[picture p88: page 16]

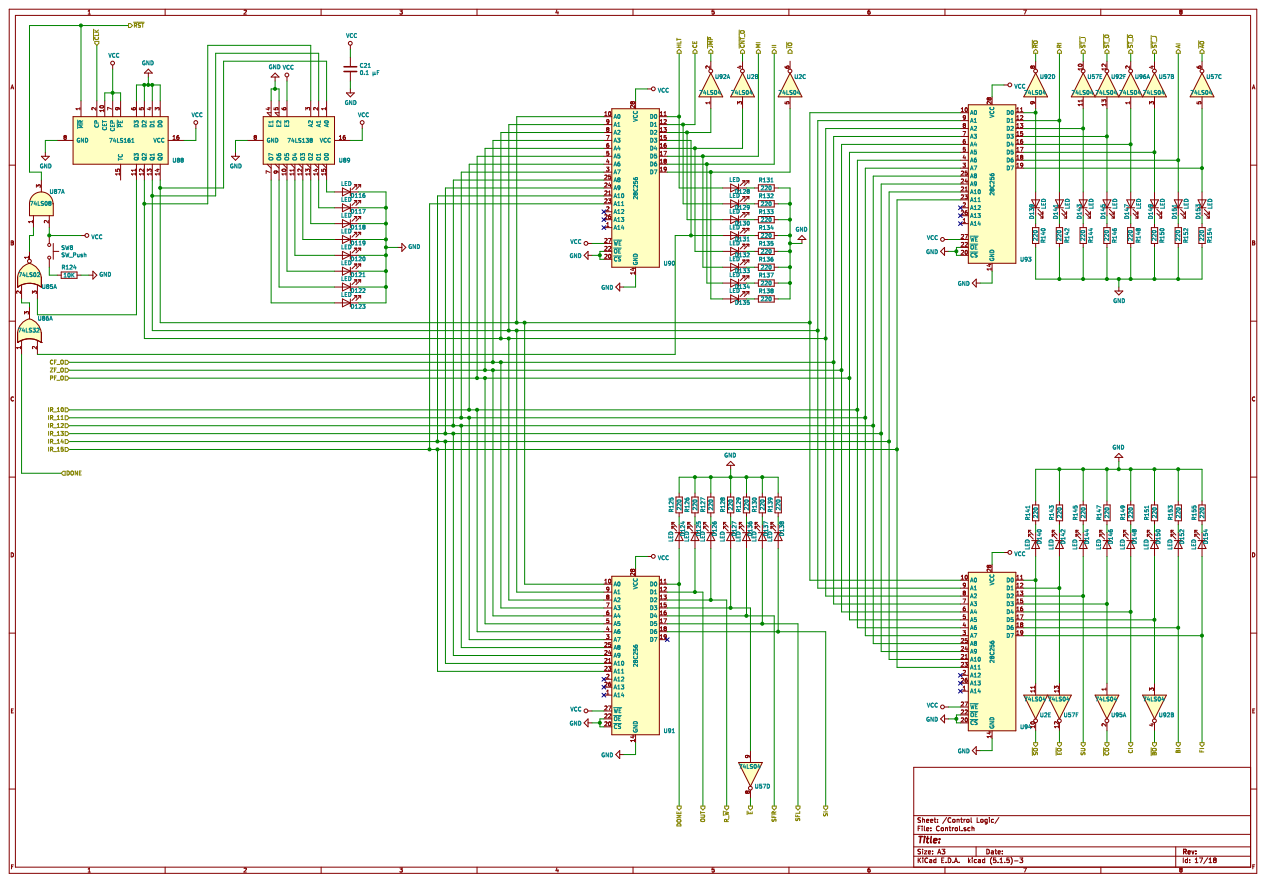
[picture p89: page 17]

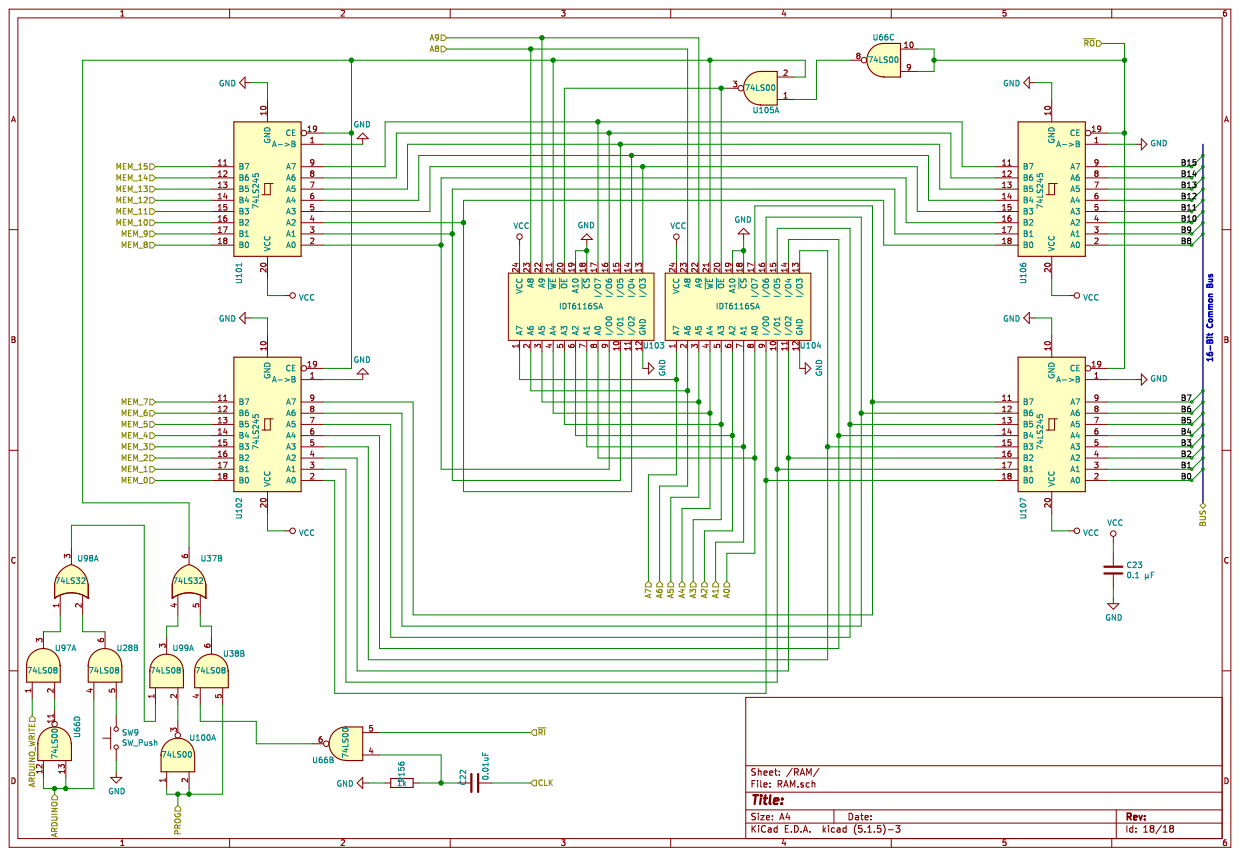
[picture p90: page 18]
