LucaDorinAnton/6CCS3PRJ/(commit log)

2020-03-18 Kicad Done
    [ALU_1.sch, A_register.sch, Address_Selector.sch, B_register.sch, C_register.sch, Control.sch, D_register.sch, Display.sch]
2020-03-19 Order Lists
    [ALU_1.sch, A_register.sch, B_register.sch, Display.sch, Instr_Register.sch, Program_Counter.sch, RAM.sch, ShiftRegister.sch]
2020-04-07 Computer built
    [ALU_1.sch, A_register.sch, Address_Selector.sch, B_register.sch, C_register.sch, Control.sch, Display.sch, FlagsRegister.sch]
2020-04-07 Eeprom organisation spreadsheet
    [eeprom_organisation.xlsx]
2020-04-17 Report Specification
    [ALU_1.sch, A_register.sch, Address_Selector.sch, B_register.sch, C_register.sch, Control.sch, Display.sch, FlagsRegister.sch]
2020-04-18 Schematic + Report Progress
    [ALU_1.sch, A_register.sch, Address_Selector.sch, B_register.sch, C_register.sch, Control.sch, Display.sch, FlagsRegister.sch]
2020-04-19 Report Progress
    [RAM.sch, StackPointer.sch]
2020-04-21 Assembler Progress
2020-04-21 Assembler done
2020-04-22 Assembler + Compiler done
2020-04-22 Prog Arduino Driver
2020-04-22 prog driver done
2020-04-22 IO driver finished
2020-04-23 Hard Implementation done
    [ALU_1.sch, B_register.sch, Display.sch, Program_Counter.sch, StackPointer.sch]
2020-04-25 Report done
    [eeprom_organisation.xlsx]
